plainFlight/plainFlightController/README.md

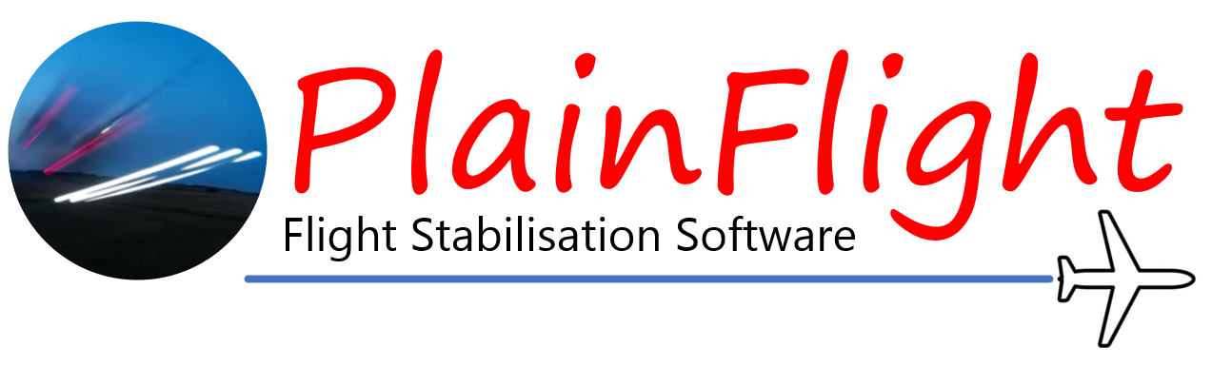
[picture p1: assets/images/PlainFlight Logo Large.PNG]

# Overview
PlainFlight stabilisation software is for the RC pilot who wants to get the most from their model, needs to master an unstable aircraft, or simply counteract environmental conditions for a more enjoyable flight.

Originally created as a home project for fixed wing model aircraft and with the intent of trying to replicate the adaptability and ease of build that the [MultiWii](https://code.google.com/archive/p/multiwii/) project had from many years ago. It quickly met my expectations with its predefined model mixes, quick customisation, good performance, ease of build and low budget parts. These qualities led to friends wanting it on their models and ultimately PlainFlight being refined and posted on GitHub for other hobbyists to have a go and enjoy.

While PlainFlight has been developed for small electric powered model planes it could easily be modified and used upon other small radio-controlled craft. This can be done with little effort as the code is broken down into logical modules and is well commented for those that want to understand or modify for their own purposes.

Several default pre-programmed model mixes can be chosen: Full house plane, full house plane V-tail (Talon), rudder/elevator plane, V-tail plane, or flying wing. The default code settings will compile for a 'full house plane' with control of 4 servo and 2 motor outputs, giving controls of ailerons/flap x2, elevator, rudder and throttle x2 (differential throttle also available for twin motor options). In addition the default code settings include 2 further pass through channels for options such as undercarriage and lights.

The flight controller hardware was originally based on the Seeed Studio XIAO ESP32-S3 but more recently preference has moved to the Waveshare Zero and Tiny due to more available IO's. All of these boards have been chosen for their small size, 32bit processing power and low cost. When combined with the ever-popular MPU6050 IMU a stable 1KHz control loop rate is easily achieved which is more than ample for fixed wing aircraft. 

If you appreciate the time and effort I have invested in this project for the community, then please help me continue development with a kind gesture (Thank you):

Please Donate (https://www.paypal.com/donate/?hosted_button_id=FC4SFQY3846UY)

## Specifications:
As standard PlainFlight has the following specifications:

| Feature | Detail |
| --- | --- |
| Model Mixes | Plane (aileron/flaps/elevator/rudder), Plane (aileron/flaps/V-tail), Plane (rudder/elevator), Plane V-Tail (rudder/elevator), Flying Wing (elevons/rudder), Quadcopter X, quadcopter P, bicopter, chinnook, tricopter, singlecopter, dualcopter. |
| Flight Modes  | Pass through, gyro rate, self levelled, heading hold, acro trainer and self levelled prop-hang.  |
| Actuators | 6 servos and 2 motors. |
| Actuators Refresh | 50Hz, 100Hz, 150Hz, 200Hz, 250Hz, 300Hz, 350Hz, Oneshot125 2KHz, (Or custom with modification).|
| Motors | Direct or differential thrust. |
| Radio Protocols | Sbus, IBus, Spektrum SRXL2 & (CRSF with battery & GPS telemetry on Main). |
| Channel Pass Through | Direct Tx channels to spare PWM outputs (on Main). |
| Battery Monitor | 1-3s Lipo as standard, actively reduces power to motor when voltage drops below a defined threshold.|
| Failsafe | Automatic transition to self levelled mode with user defined failsafe flight trims and cuts throttle.|
| LED | Flight mode indication.|
| Target| Seeed Studio XIAO ESP32-S3. Waveshare ESP32-S3 Tiny or Zero, or any suitable ESP32-S3 board.|
| IMU | MPU6050. |
| Control Loop | Stable 1KHz.|
| WiFi/Web Configurator | Configure gains with your smart device or PC. |
| GPS | CASIC & UBLOX M6/M7/M8/M9/M10 for telemetry purposes only (on Main). |

## Hardware:

All hardware is readily available from hobbyist electronics shops with the main components being:

**Seeed Studio:** [XIAO ESP32-S3](https://wiki.seeedstudio.com/xiao_esp32s3_getting_started/)
**Waveshare:** [Tiny ESP32-S3](https://www.waveshare.com/wiki/ESP32-S3-Tiny)
**Waveshare:** [Zero ESP32-S3](https://www.waveshare.com/wiki/ESP32-S3-Zero)

**MPU6050:** [GY-521 Breakout Board](https://www.amazon.co.uk/MPU-6050-Accelerometer-Gyroscope-Converter-Arduino/dp/B0BZXT477Z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)
**MPU6050:** [ZY-MPU6050 Breakout Board](https://www.aliexpress.com/item/1005005968483503.html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)

The following wiring diagram details how to assemble the flight controller from component parts for a typical model. For full details on wiring and setup please see instructions/directions manual:

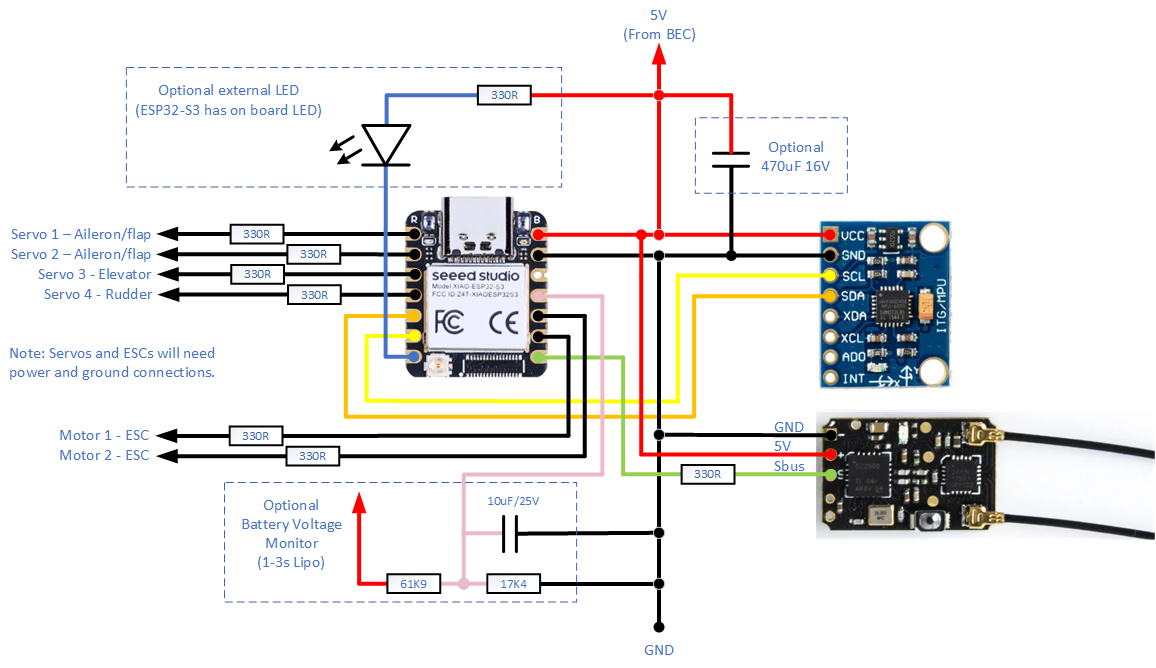
[picture p2: assets/images/plainFlight Controller Connection Diagram.png]
Wiring diagram


A typical 'full house' flight controller build with 6 channels and battery monitoring:
<p align="center">
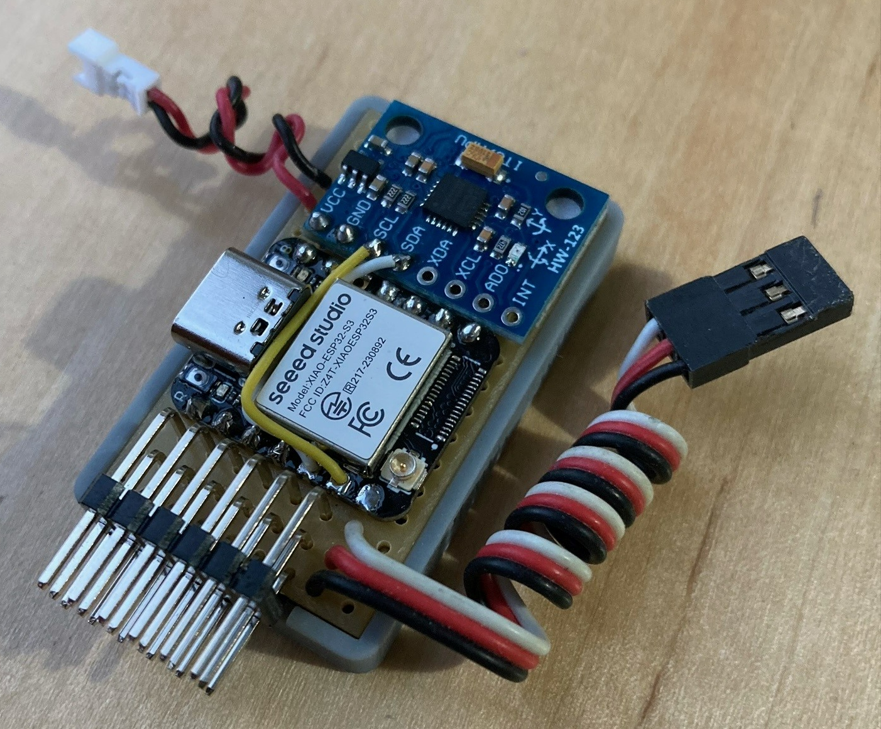
[picture p3: assets/images/PF_5V_Build.PNG]

</p>

## Instruction Manual:

The plainFlightController repository includes a comprehensive instruction manual that takes you through Arduino and flight controller setup for your model:

Instruction Manual

## Web Configurator

Use your smart device to connect wirelessly to your plainFlightController to set gains, rates, servo trims, level trims and battery voltage calibration. This allows easy tuning of your model when out at your flying site.

<p align="center">
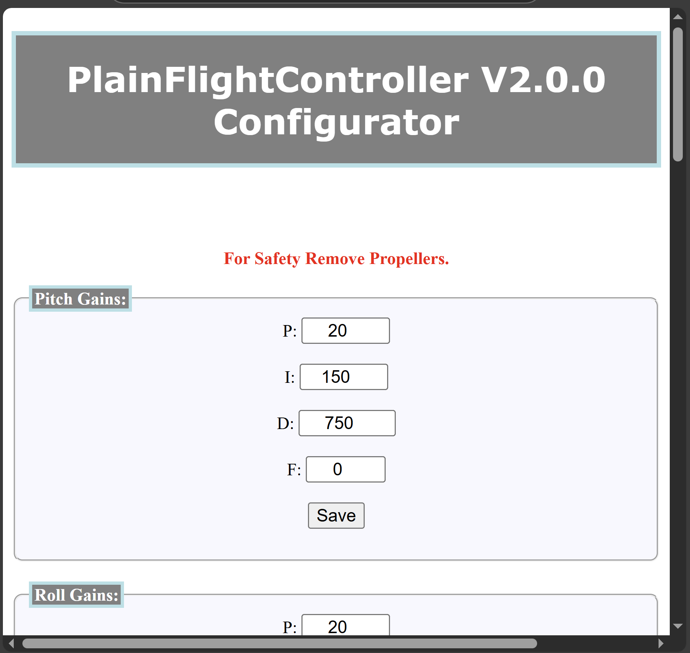
[picture p4: assets/images/WebConfig.png]

</p>

## PCB's:

This project offers PCB's that you can order from pcbway.com or jlcpcb.com. Just copy and paste the zipped files in the manufacture folder onto their websites to get an instant quote. Ordinarily 5-10 bare PCBs with 8-10 day postage comes in under $15US.

 **WSMC**

The Waveshare module carrier (WSMC) is a through hole design that is easy to build. It supports all software features provided by Plain Flight Controller.  

<p align="center">
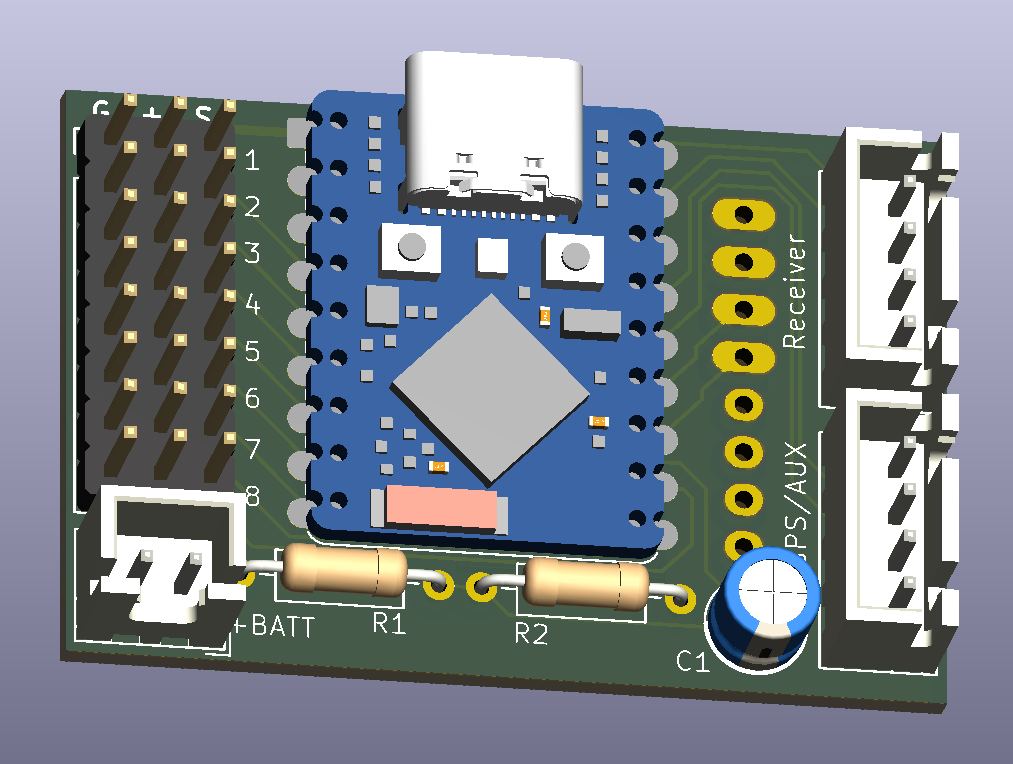
[picture p5: PCBs/WSMC/Assets/WSMC_3D.png]

</p>

 **WSMC Mini**

The Waveshare module carrier Mini (WSMC Mini) is a SMT design. Suitable for smaller models but does require a few discrete 0805 components to be soldered. As per WSMC it supports all software features provided by Plain Flight Controller.

<p align="center">
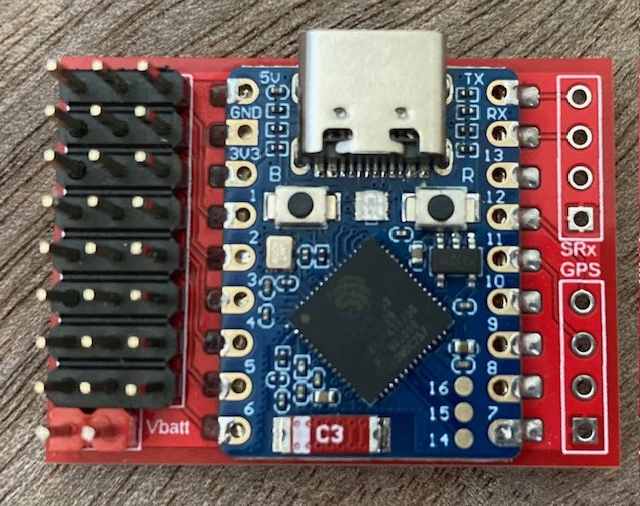
[picture p6: PCBs/WSMC Mini/Assets/WSMC_Mini_Top.png]

</p>

## Movies:

PlainFlight controller introduction, with signature hands off knife edge:

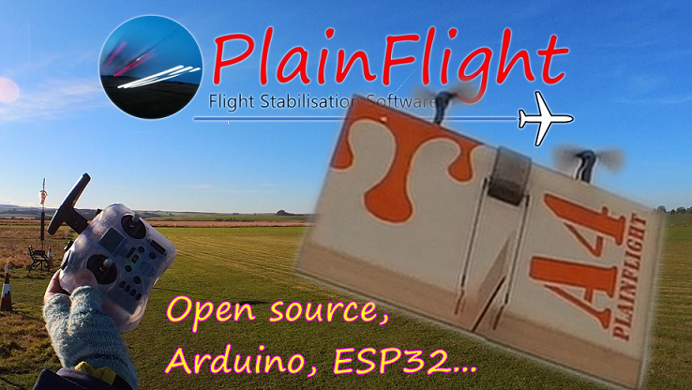
[picture p7: assets/images/vid2.PNG]
Vid1 (https://youtu.be/_j3ObBTJ5ag)


BiCopter is one of many multicopters now available with V2.0.0 release:

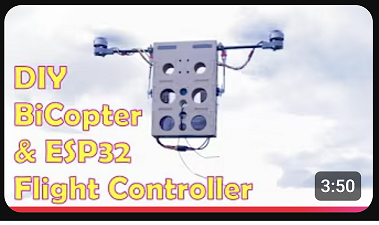
[picture p8: assets/images/BiCopter2.PNG]
Vid4 (https://youtu.be/dmMqcb41KNQ?si=f0tuzXE5j9zyYHdB)


Twin differential flying wing 'A4' - Hands off take off using differential thrust and heading hold feature. As of V2.0.0 this can be achieved with the self level prop-hang feature:

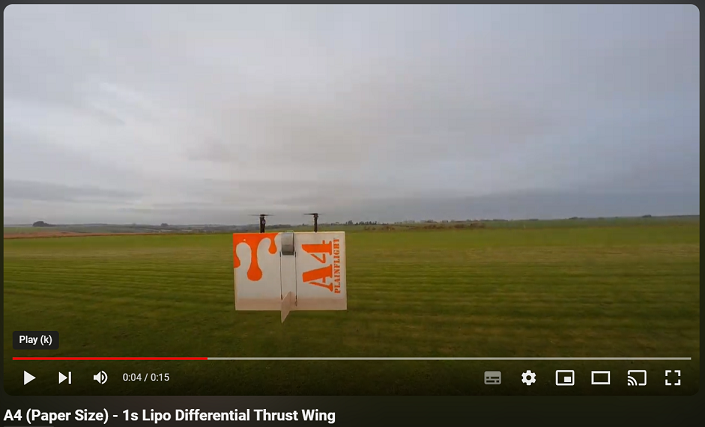
[picture p9: assets/images/A4 Wing.PNG]
Vid2 (https://youtu.be/VJwikkyEEPw)


Testing the effect of D-gain on a fixed wing model. Despite popular belief it works and from my experiences has the benefit of softening P gain 'bobbles' caused by overshoot, and removes the need for throttle attenuation of gains. NOTE: You will need a laptop sized screen for this video:

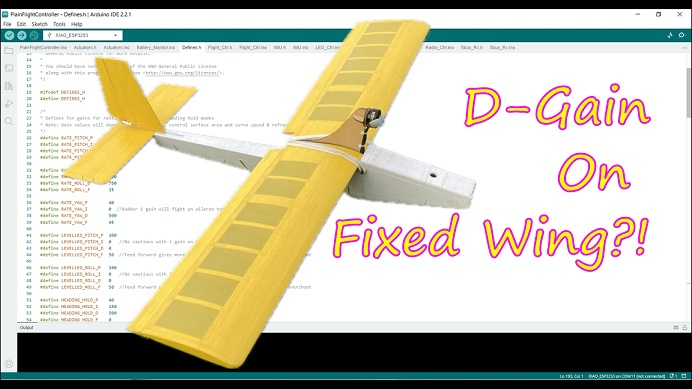
[picture p10: assets/images/D-Gain Thumb.jpg]
Vid3 (https://youtu.be/jslFuttht5o)


## In Development

New features that will be in V3.x.x:

GPS telemetry is in final stages of testing, Casic and Ublox supported.
Battery telemetry.
Rx base class created and Crossfire (CRSF) with telemetry support has been added with full 250Hz update rate.
Move to SoftWire library for I2C as it saves ~250us per loop over Arduino Wire.
Channel pass through so Tx channels can be directly output for undercarriage or lights etc.
Board configurations added ESP32S3 XIAO, Tiny and Zero.
Ability to configure RGB or GRB neopixels.
Enhanced WiFi/web configurator GUI.
Update to configuration.
...These changes are currently on Main for testing.

Plus there is always something new being thought about, and a few secret projects in the works.

## Planned

V3.x.x is planned for release and includes the items mentioned above.

PCB layouts to support Plain Flight Controller.

## Community

I am open to contributions but please be aware it may take me several weeks to assess and test any submissions. Please ensure code is in the same coding style/standard and well commented. I reserve the right to decline contributions that I feel may not be in keeping with the project or standards. 

## Disclaimer:

Do not expect this software to out perform other more established flight controller projects such as ArduPilot, inav, betaFlight etc. This code shall be considered as highly experimental and is not designed or written to any safety critical, or mission critical standards. It is given/shared for free with the knowledge and understanding that this open source flight controller software is only for small hobby based electrically powered model aircraft, or other small hobby radio controlled vehicles. It is intended to be used or modified to suit your needs for small models and is NOT to be used on any manned vehicles. The author(s) shall not be held responsible or accountable for any damage, injury or loss that may be inflicted or incurred as a result of the use or misuse of this code. Use and modify at your own risk and use within accordance of your country's laws and/or regulations. 

By using this, or any part of this software you agree to [this license agreement.](https://github.com/plainFlight/plainFlightController/blob/main/LICENSE)

...and to put it more bluntly:

THIS SOFTWARE IS PROVIDED BY THE CONTRIBUTORS "AS IS" AND ANY EXPRESS OR IMPLIED WARRANTIES, INCLUDING, BUT NOT LIMITED TO, THE IMPLIED WARRANTIES OF MERCHANTABILITY AND FITNESS FOR A PARTICULAR PURPOSE ARE DISCLAIMED. IN NO EVENT SHALL THE CONTRIBUTORS BE LIABLE FOR ANY DIRECT, INDIRECT, INCIDENTAL, SPECIAL, EXEMPLARY, OR CONSEQUENTIAL DAMAGES (INCLUDING, BUT NOT LIMITED TO, PROCUREMENT OF SUBSTITUTE GOODS OR SERVICES; LOSS OF USE, DATA, OR PROFITS; OR BUSINESS INTERRUPTION) HOWEVER CAUSED AND ON ANY THEORY OF LIABILITY, WHETHER IN CONTRACT, STRICT LIABILITY, OR TORT (INCLUDING NEGLIGENCE OR OTHERWISE) ARISING IN ANY WAY OUT OF THE USE OF THIS SOFTWARE, EVEN IF ADVISED OF THE POSSIBILITY OF SUCH DAMAGE.
