plainFlight/plainFlightController/PCBs/WSMC Mini/Schematic/Read Me.txt

Schematic is on its way!

WSMC Mini has the same pin mapping as WSMC. 

Use BoardConfig::WSMC in Config.hpp.
