plainFlight/plainFlightController/PCBs/WSMC Mini/WSMC Mini Specification.txt

Waveshare Module Carrier Mini (WSMC Mini).

Designed by Plain Flight (P.Cook) 2026.

Specification:

Supports: Waveshare ESP32S3 Zero
Supports: 8 PWM Outputs
Supports: serial receivers with telemetry
Supports: GPS
Supports: battery voltage monitoring
Supports: ZY-MPU6050 only
Supports: 5V operation only
Supports: On board Neopixel
Size: 25mm x 34.5mm

Tested By:

Plain Flight
