plainFlight/plainFlightController/assets/images/vid1.PNG

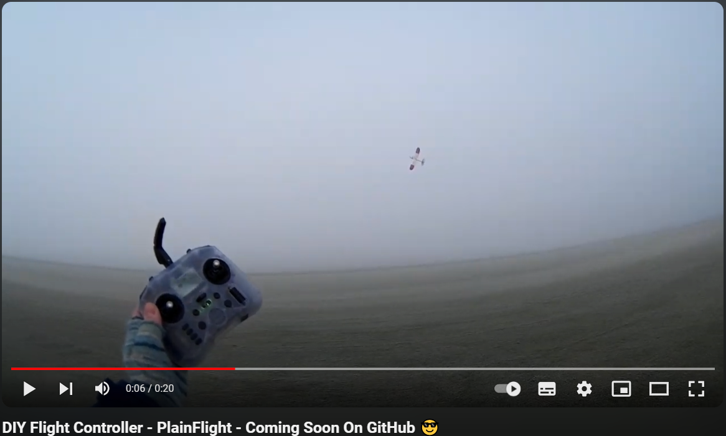
assets/images/vid1.PNG
