plainFlight/plainFlightController/PCBs/WSMC Mini/Assets/WSMC_Mini_Bottom.png

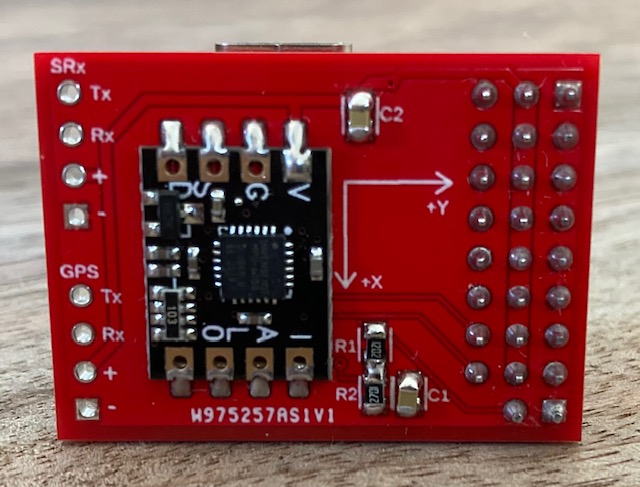
PCBs/WSMC Mini/Assets/WSMC_Mini_Bottom.png
