plainFlight/plainFlightController/PCBs/WSMC/Assets/WSMC_Bottom.png

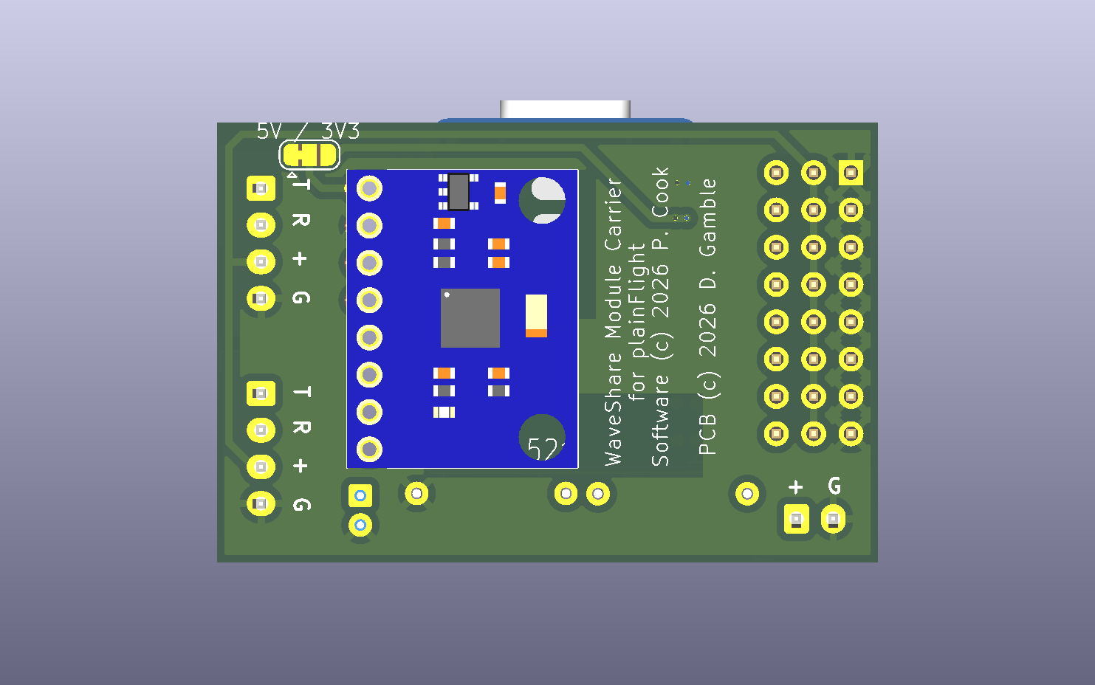
PCBs/WSMC/Assets/WSMC_Bottom.png
