plainFlight/plainFlightController/PCBs/WSMC/Assets/WSMC_Top.png

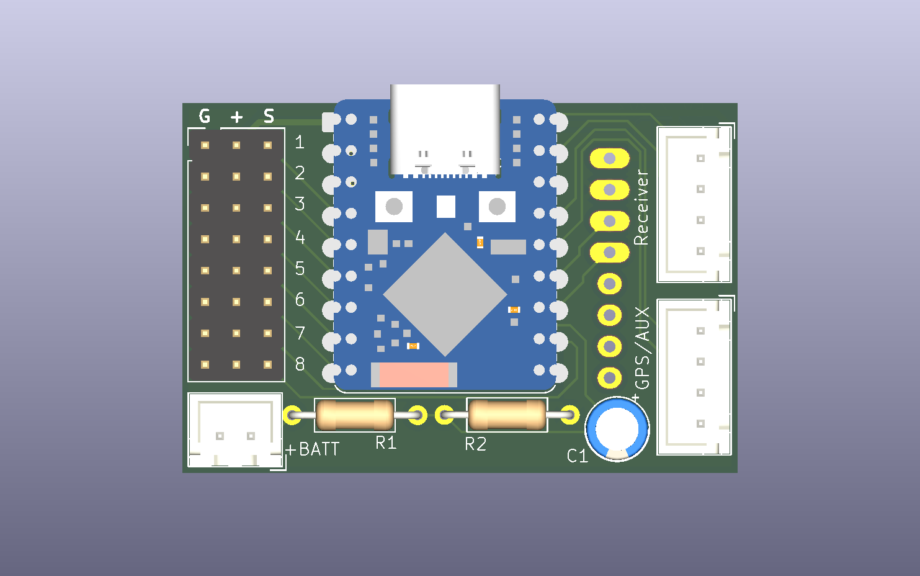
PCBs/WSMC/Assets/WSMC_Top.png
