plainFlight/plainFlightController/(threads)

Thread 2 (2024-05-18):

Compilation error

01Space, 2024-05-18:
Hello! Your code is fantastic! I tried to compile the code and found that the ARDUINO IDE prompted that it could not be compiled.

C:\Users\86186\Downloads\plainFlightController-1.0.0\PlainFlightController\Actuators.ino: In function 'void initActuators()':
Actuators:55:7: error: 'ledcSetup' was not declared in this scope
   55 |       ledcSetup(i, SERVO_REFRESH, LEDC_RESOLUTION);
      |       ^~~~~~~~~
Actuators:56:7: error: 'ledcAttachPin' was not declared in this scope; did you mean 'ledcAttach'?
   56 |       ledcAttachPin(pwmPin[i], i);
      |       ^~~~~~~~~~~~~
      |       ledcAttach
Actuators:74:9: error: 'ledcSetup' was not declared in this scope
   74 |         ledcSetup(i, SERVO_REFRESH, LEDC_RESOLUTION);
      |         ^~~~~~~~~
Actuators:75:9: error: 'ledcAttachPin' was not declared in this scope; did you mean 'ledcAttach'?
   75 |         ledcAttachPin(pwmPin[i], i);
      |         ^~~~~~~~~~~~~
      |         ledcAttach

plainFlight, 2024-05-18:
Sounds like you have not downloaded/installed the ESP32 Espressif library... see the instructions for what libraries are needed. The functions Arduino is complaining about are part of that library.

01Space, 2024-05-19:
Thank you! I have resolved the compilation issue. The problem is that I am using Espressif Systems ESP32 (3.0.0-RC3) and can compile using an older version (2.0.14)
Can you share the 3D printing design files and ARDUINO source code of BiCopter/DualCopter? Many people are very interested in your BiCopter/DualCopter project! Do you use Discord server? You can establish a Discord server for PlainFlightController, so that anyone interested in PlainFlightController can join the Discord server for communication or discussion.

Closed 2024-05-19.

Thread 4 (2024-09-21):

Not compiling with newest Arduino IDE

Eisbaeeer, 2024-09-21:
Hi
I tried to compile fresh installation of Arduino (as in manual).

Arduino 2.3.2
MPU6050 1.3.1
esp32 Espressif Systems 3.0.4

Throwing this error:
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

Is it possible to move the source to platformio?
This will be more stable regarding updates of lib´s.

Greets Lars

plainFlight, 2024-09-21:
Manual shows 2.0.14 for Espressif Systems library. It will compile with that version.

Eisbaeeer, 2024-09-22:
The sketch is compiling with 2.0.14
Thanks a lot!

Closed 2024-09-22.

Thread 5 (2024-10-29):

Board compatibility issue

Eisbaeeer, 2024-10-29:
Im using a Waveshare ESP32-S3 ZERO board.
I love this project. You spend so much time for it.
I converted to platformio for using other boards. Are you interested for a pull request?
Greets Lars

Closed 2024-10-30.

Thread 6 (2024-11-29):

ESP32-WROOM-32

alex2root, 2024-11-29:
Hello,

I really like your project!)))

I am using the ESP32-WROOM-32,

and I hope that in the updated project, I will still be able to use my affordable alternative.

kd8ua, 2024-12-06:
Hello Alex,

This is one of several projects that I am following and hoping to replicate and perhaps even improve on.

Though, my expertise is minimal I have been having some success.  I have assembled a board for the plainFlightController using the schematic, photos and compiled and uploaded the code available from this project successfully.

The good news is that I did not produce any magic smoke when I  powered up the board. I hooked up a couple of servos to the board this evening and after power up, when I lift and move the board, the servos react as if they are trying to maintain level flight.  So that looks good too.

I am looking at plans and even kits for a suitable airplane platform, as well as gathering all of the other necessary parts. to put an airplane in the air early next spring.                                                              

What stage are you in this project Alex?
Hope to hear from you and perhaps compare notes as we work on this project?

Regards, Don

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

Thread 8 (2025-04-01):

Defines.h vs. defines.h

ofpkubi, 2025-04-01:
Hi,

I'm trying to compile v1.1.1 the project on Linux and it complains about "defines.h" in Sbus_Rx.ino.
There is a "Defines.h" (capital D), so if I fix the name in Sbus_Rx.ino, it complies.

I think, it is a typo that causes issue only with case sensitive filesystems (e.g., ext4 in Linux).

plainFlight, 2025-05-04:
Closed as V2.0.0 no longer uses Defines.h.

Closed 2025-05-04.

Thread 9 (2025-04-27):

im using MP6500 instead of MPU6050 GY-521

ranger2012, 2025-04-27:
is there a way to change the IMU library frin MPU6050 to MPU6500..?

plainFlight, 2025-05-04:
Closed as not an issue with the code base.

Closed 2025-05-04.
