plainFlight/plainFlightController/PCBs/WSMC/Schematic/WSMC_Schematic V1.0.pdf

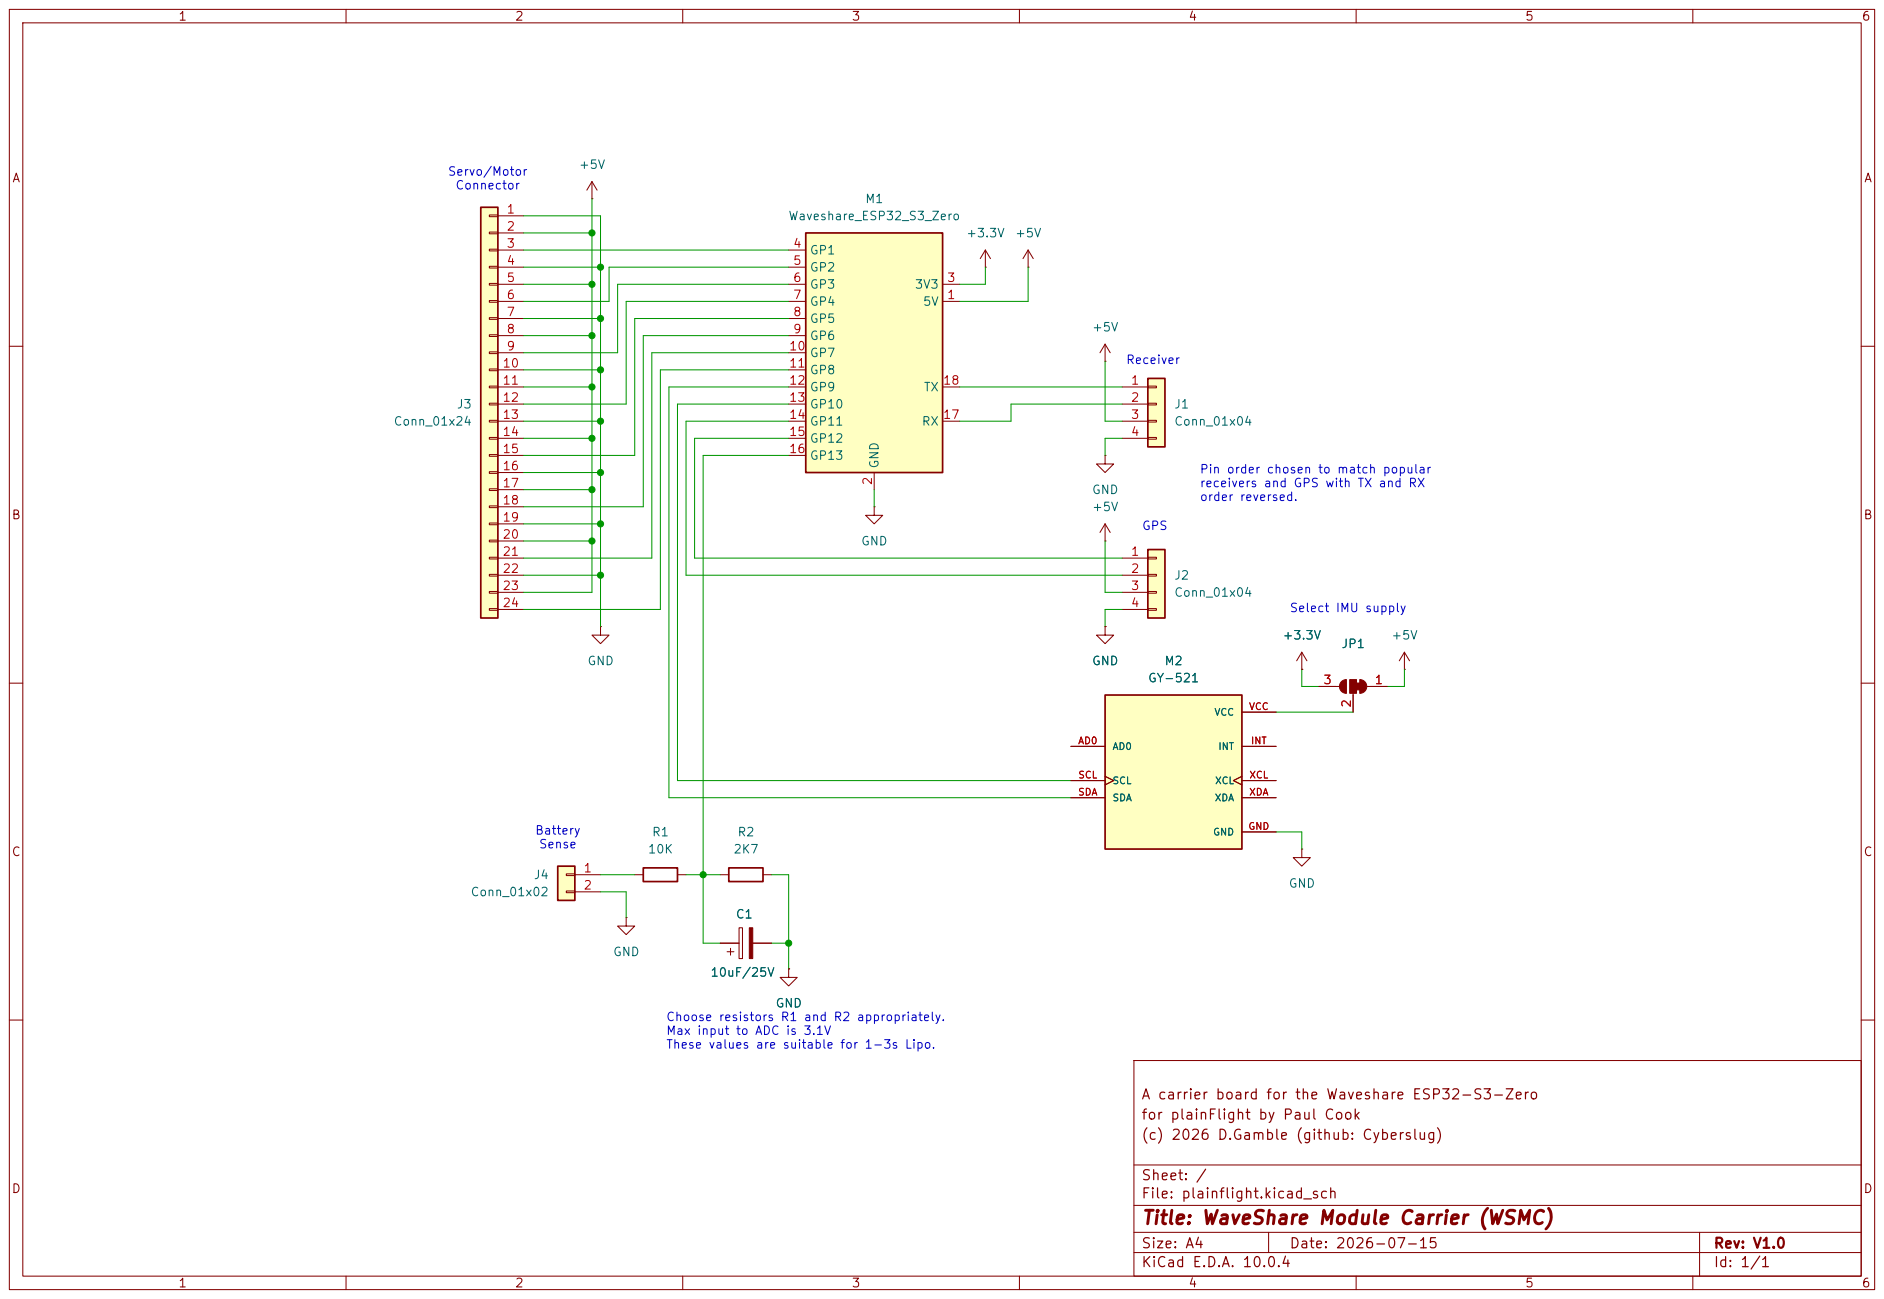
[picture p77: page 1]

receivers and GPS with TX and RX order reversed. Battery Sense

A carrier board for the Waveshare ESP32-S3-Zero
for plainFlight by Paul Cook
(c) 2026 D.Gamble (github: Cyberslug)

Sheet: /
File: plainflight.kicad_sch
Title: WaveShare Module Carrier (WSMC)

Size: A4 | Rev: V1.0
KiCad E.D.A. 10.0.4 | Id: 1/1
