plainFlight/plainFlightController/PlainFlightController/PlainFlightController.ino

/* 
* Copyright (c) 2025 P.Cook (alias 'plainFlight')
*
* This file is part of the PlainFlightController distribution (https://github.com/plainFlight/plainFlightController).
* 
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
* You should have received a copy of the GNU General Public License 
* along with this program. If not, see <http://www.gnu.org/licenses/>.
*/

/**
* @file   plainFlightController.ino 
* @brief  Contains Arduino setup and loop.
*/

#include "FlightControl.hpp"


//Create instance of FlightControl...
FlightControl plainFlightController = FlightControl();


void setup() 
{
  plainFlightController.begin(); 
}


void loop() 
{
 plainFlightController.operate();
}
