plainFlight/plainFlightController/PlainFlightController/WifiConfig.cpp

/* 
* Copyright (c) 2025 P.Cook (alias 'plainFlight')
*
* This file is part of the PlainFlightController distribution (https://github.com/plainFlight/plainFlightController).
* 
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
* You should have received a copy of the GNU General Public License 
* along with this program. If not, see <http://www.gnu.org/licenses/>.
*/

/**
* @file   WifiConfig.cpp
* @brief  This class contains methods that controls the wifi and HTML web page.
*/

#include "WifiConfig.hpp"
#include "Config.hpp"
#include "InternalConfig.hpp"


/**
* @brief    Constructore.
* @param    Parameters to be displayed/updated by the WiFi configurator
* @note     TODO - this can be done better in the hpp.
*/
WifiConfig::WifiConfig(FileSystem::NonVolatileData * const theData, float* const batteryVoltage, float* const pitch, float* const roll, float* const yaw)
{
  m_webData = theData;
  m_batteryVoltage = batteryVoltage;
  m_pitch = pitch;
  m_roll = roll;
  m_yaw = yaw;
}


/**
* @brief  Wifi state machine enabled by high throttle stick position when disarmed.
*/
void 
WifiConfig::doWiFiStateMachine()
{
  switch (m_state)
  {
    case WifiState::OFF:
      if constexpr(InternalConfig::DEBUG_CONFIGURATOR){Serial.println("wifi_off");}
      break;

    case WifiState::START:
    {
      if constexpr(InternalConfig::DEBUG_CONFIGURATOR){Serial.println("start_wifi");}
      const bool ok = startWifiConfigurator();
      m_state = (ok) ? WifiState::SERV_CLIENT : WifiState::OFF;
      break;
    }

    default:
    case WifiState::STOP:
      if constexpr(InternalConfig::DEBUG_CONFIGURATOR){Serial.println("stop_wifi");}
      stopWifiConfigurator();
      m_state = WifiState::OFF;
      break;
    
    case WifiState::SERV_CLIENT:
    {
      //serviceWifiConfigurator();
      dnsServer.processNextRequest();
      server.handleClient();
      break;  
    } 
  }
}


/**
* @brief  Initiates a wifi access point and server.
* @return True if wifi started.
*/
bool 
WifiConfig::startWifiConfigurator() 
{
  if constexpr(InternalConfig::DEBUG_CONFIGURATOR){Serial.println("Configuring access point...");}

  IPAddress m_localIP(192,168,4,1);
  IPAddress m_gateway(192,168,4,1);
  IPAddress m_subnet(255,255,255,0);

  WiFi.softAPConfig(m_localIP, m_gateway, m_subnet);

  if (!WiFi.softAP(SSID, PASSWORD))
  {
    if constexpr(InternalConfig::DEBUG_CONFIGURATOR){Serial.println("Soft AP failed.");}
    return false;
  }

  m_localIP = WiFi.softAPIP();
  //Using dns to create a captive portal in an effort to automatically open a webpage.
  dnsServer.start(53, "*", m_localIP);

  //Pages
  server.on(STR_PAGE_ROOT, HTTP_GET, [this](){handleRoot();});
  server.on(STR_PAGE_MAIN, HTTP_GET, [this](){sendMain();});
  
  //Forms
  server.on(STR_FORM_PITCH, HTTP_POST, [this](){handlePitchGains();});
  server.on(STR_FORM_ROLL, HTTP_POST, [this](){handleRollGains();});
  server.on(STR_FORM_YAW, HTTP_POST, [this](){handleYawGains();});
  server.on(STR_FORM_RATES, HTTP_POST, [this](){handleDegreeRates();});
  server.on(STR_FORM_ANGLE, HTTP_POST, [this](){handleMaxLevelAngles();});
  server.on(STR_FORM_LEVEL_TRIMS, HTTP_POST, [this](){handleLevelTrims();});
  server.on(STR_FORM_SERVO_TRIMS, HTTP_POST, [this](){handleServoTrims();});
  server.on(STR_FORM_VOLT_TRIM, HTTP_POST, [this](){handleBatteryTrim();});

  //Captive portal detection
  server.on(STR_PORTAL_ROOT_1, HTTP_GET, [this](){handleRoot();});
  server.on(STR_PORTAL_ROOT_2, HTTP_GET, [this](){handleRoot();});
  server.on(STR_PORTAL_ROOT_3, HTTP_GET, [this](){handleRoot();});
  server.on(STR_PORTAL_ROOT_4, HTTP_GET, [this](){handleRoot();});
  server.on(STR_PORTAL_ROOT_5, HTTP_GET, [this](){handleRoot();});
  server.onNotFound([this](){handleNotFound();});

  //Handle live updates
  server.on(STR_LIVE_UPDATE_MODEL, HTTP_GET, [this](){handleModelUpdates();});

  server.begin();
  return true;
}


/**
* @brief  Disconnects and turns off wifi.
* @note   Wifi is always off when the model is armed.
*/
void 
WifiConfig::stopWifiConfigurator() 
{
  if constexpr(InternalConfig::DEBUG_CONFIGURATOR){Serial.println("Client Disconnected.");}
  WiFi.softAPdisconnect();
  WiFi.mode(WIFI_OFF);
  if constexpr(InternalConfig::DEBUG_CONFIGURATOR){Serial.println("Wifi stopped");}
}


/**
* @brief  Informs caller when new data has been captured.
* @return true when a value has been updated.
*/
bool 
WifiConfig::hasUpdatedData()
{
  const bool updated = m_dataUpdated;
  m_dataUpdated = false;
  return updated;
}


/**
* @brief    Send the main HTML page.
*/
void
WifiConfig::sendMain()
{
  int32_t degreesPerSec = 0;

  if constexpr(Config::GYRO_RATE == GyroRate::IS_250_DEGS_SECOND)
  {
    degreesPerSec = 250;
  }
  else
  {
    if constexpr(Config::GYRO_RATE == GyroRate::IS_500_DEGS_SECOND)
    {
      degreesPerSec = 500;
    }
  }

  const int32_t n = snprintf (m_html, HTML_DOC_BUFF_SIZE, INDEX_HTML, 
                          InternalConfig::SOFTWARE_VERSION,
                          m_webData->gains.pitch.p, m_webData->gains.pitch.i, (m_webData->gains.pitch.d/SCALE_D_GAIN), m_webData->gains.pitch.ff, m_webData->gains.pitch.dff,
                          m_webData->gains.roll.p, m_webData->gains.roll.i, (m_webData->gains.roll.d/SCALE_D_GAIN), m_webData->gains.roll.ff, m_webData->gains.roll.dff, 
                          m_webData->gains.yaw.p, m_webData->gains.yaw.i, (m_webData->gains.yaw.d/SCALE_D_GAIN), m_webData->gains.yaw.ff, m_webData->gains.yaw.dff, 
                          (m_webData->rates.pitch/SCALE_RATES), degreesPerSec, (m_webData->rates.roll/SCALE_RATES), degreesPerSec, (m_webData->rates.yaw/SCALE_RATES), degreesPerSec, 
                          (m_webData->maxAngle.pitch/SCALE_MAX_ANGLE), (m_webData->maxAngle.roll/SCALE_MAX_ANGLE), 
                          *m_pitch, *m_roll, *m_yaw, m_webData->levelTrim.pitch, m_webData->levelTrim.roll, m_webData->levelTrim.yaw,
                          m_webData->servoTrim.servo1, m_webData->servoTrim.servo2, m_webData->servoTrim.servo3, m_webData->servoTrim.servo4,
                          *m_batteryVoltage, m_webData->batteryScaler);

  if (HTML_DOC_BUFF_SIZE < (n+1))
  {
    Serial.println("snprintf buff size error !");
  }
  else
  {
    server.send(200, STR_TEXT_HTML, m_html);
  }
}
    

/**
* @brief    Handle root.
*/
void
WifiConfig::handleRoot()
{
  if constexpr(InternalConfig::DEBUG_CONFIGURATOR){Serial.println("handle root");}

  server.sendHeader(STR_LOCATION, STR_ESP_MAIN_URL, true);
  server.send(302, STR_TEXT_PLAIN, "");
}


/**
* @brief    Handle web requests that are not known.
*/
void
WifiConfig::handleNotFound()
{
  if constexpr(InternalConfig::DEBUG_CONFIGURATOR){Serial.println("handle not found");}

  server.sendHeader(STR_LOCATION, STR_ESP_MAIN_URL, true);
  server.send(302, STR_TEXT_PLAIN, "");
}


/**
* @brief    Common decoding method for all PIDF gains.
* @param    Pointer to gains structure to populate.
*/
void
WifiConfig::updateGains(PIDF::Gains* const theGains)
{
  const int32_t P = server.arg(ARG_P).toInt();
  const int32_t I = server.arg(ARG_I).toInt();
  const int32_t D = server.arg(ARG_D).toInt() * SCALE_D_GAIN;
  const int32_t F = server.arg(ARG_F).toInt();
  const int32_t DFF = server.arg(ARG_DFF).toInt();

  if constexpr(InternalConfig::DEBUG_CONFIGURATOR)
  {
    Serial.println("Gains updated:");
    Serial.println("P:" + String(P));
    Serial.println("I:" + String(I));
    Serial.println("D:" + String(D));
    Serial.println("F:" + String(F));
    Serial.println("DFF:" + String(DFF));
  }

  theGains->p = P;
  theGains->i = I;
  theGains->d = D;
  theGains->ff = F;
  theGains->dff = DFF;
}


/**
* @brief    Decode the pitch gains.
*/
void
WifiConfig::handlePitchGains()
{
  updateGains(&m_webData->gains.pitch);
  server.sendHeader(STR_LOCATION, STR_PAGE_MAIN);
  server.send(303);
  m_dataUpdated = true;
}


/**
* @brief    Decode the roll gains.
*/
void
WifiConfig::handleRollGains()
{
  updateGains(&m_webData->gains.roll);
  server.sendHeader(STR_LOCATION, STR_PAGE_MAIN);
  server.send(303);
  m_dataUpdated = true;
}


/**
* @brief    Decode the yaw gains.
*/
void
WifiConfig::handleYawGains()
{
  updateGains(&m_webData->gains.yaw);
  server.sendHeader(STR_LOCATION, STR_PAGE_MAIN);
  server.send(303);
  m_dataUpdated = true;
}


/**
* @brief    Decode the degrees pers second rates
*/
void
WifiConfig::handleDegreeRates()
{
  const int32_t pitch = server.arg(ARG_PITCH).toInt() * SCALE_RATES;
  const int32_t roll = server.arg(ARG_ROLL).toInt() * SCALE_RATES;
  const int32_t yaw = server.arg(ARG_YAW).toInt() * SCALE_RATES;

  if constexpr(InternalConfig::DEBUG_CONFIGURATOR)
  {
    Serial.println("Degree rates updated:");
    Serial.println("Pitch:" + String(pitch));
    Serial.println("Roll:" + String(roll));
    Serial.println("Yaw:" + String(yaw));
  }

  m_webData->rates.pitch = pitch;
  m_webData->rates.roll = roll;
  m_webData->rates.yaw = yaw;

  server.sendHeader(STR_LOCATION, STR_PAGE_MAIN);
  server.send(303);
  m_dataUpdated = true;
}


/**
* @brief    Decode the max angle trims
*/
void
WifiConfig::handleMaxLevelAngles()
{
  const int32_t pitch = server.arg(ARG_PITCH).toInt() * SCALE_MAX_ANGLE;
  const int32_t roll = server.arg(ARG_ROLL).toInt() * SCALE_MAX_ANGLE;

  if constexpr(InternalConfig::DEBUG_CONFIGURATOR)
  {
    Serial.println("Level rates updated:");
    Serial.println("Pitch:" + String(pitch));
    Serial.println("Roll:" + String(roll));
  }

  m_webData->maxAngle.pitch = pitch;
  m_webData->maxAngle.roll = roll;

  server.sendHeader(STR_LOCATION, STR_PAGE_MAIN);
  server.send(303);
  m_dataUpdated = true;
}


/**
* @brief    Decode the new level trims
*/
void
WifiConfig::handleLevelTrims()
{
  const float pitch = server.arg(ARG_PITCH).toFloat();
  const float roll = server.arg(ARG_ROLL).toFloat();
  const float yaw = server.arg(ARG_YAW).toFloat();

  if constexpr(InternalConfig::DEBUG_CONFIGURATOR)
  {
    Serial.println("Level trims updated:");
    Serial.println("Pitch:" + String(pitch));
    Serial.println("Roll:" + String(roll));
    Serial.println("Yaw:" + String(yaw));
  }

  m_webData->levelTrim.pitch = pitch;
  m_webData->levelTrim.roll = roll;
  m_webData->levelTrim.yaw = yaw;     //Note: This is used to trim level when in prophang mode

  server.sendHeader(STR_LOCATION, STR_PAGE_MAIN);
  server.send(303);
  m_dataUpdated = true;
}


/**
* @brief    Decode the new servo trims
*/
void
WifiConfig::handleServoTrims()
{
  const int32_t servo1 = server.arg(ARG_SERVO1).toInt();
  const int32_t servo2 = server.arg(ARG_SERVO2).toInt();
  const int32_t servo3 = server.arg(ARG_SERVO3).toInt();
  const int32_t servo4 = server.arg(ARG_SERVO4).toInt();

  if constexpr(InternalConfig::DEBUG_CONFIGURATOR)
  {
    Serial.println("Servo trims updated:");
    Serial.println("servo1:" + String(servo1));
    Serial.println("servo2:" + String(servo2));
    Serial.println("servo3:" + String(servo3));
    Serial.println("servo4:" + String(servo4));
  }

  m_webData->servoTrim.servo1 = servo1;
  m_webData->servoTrim.servo2 = servo2;
  m_webData->servoTrim.servo3 = servo3;
  m_webData->servoTrim.servo4 = servo4;

  server.sendHeader(STR_LOCATION, STR_PAGE_MAIN);
  server.send(303);
  m_dataUpdated = true;
}


/**
* @brief    Decode the new battery scaler
*/
void
WifiConfig::handleBatteryTrim()
{
  const float voltCalibration = server.arg(ARG_VOLTS).toFloat();

  if constexpr(InternalConfig::DEBUG_CONFIGURATOR)
  {
    Serial.println("Voltage calibration updated:");
    Serial.print("Cal:");
    Serial.println(voltCalibration, 5);
  }

  m_webData->batteryScaler = voltCalibration;

  server.sendHeader(STR_LOCATION, STR_PAGE_MAIN);
  server.send(303);
  m_dataUpdated = true;
}


/**
* @brief    Process and send live updates.
*/
void
WifiConfig::handleModelUpdates()
{
  constexpr uint8_t BUFF_SIZE = 96U;
  char json[BUFF_SIZE] = {0};

  const int32_t n = snprintf(
            json, sizeof(json),
            "{\"pitch\":%.1f,\"roll\":%.1f,\"yaw\":%.1f,\"volts\":%.2f}",
            *m_pitch, *m_roll, *m_yaw, *m_batteryVoltage);

  if constexpr(InternalConfig::DEBUG_CONFIGURATOR)
  {
    Serial.println("Get angle/volts Updates:");
    Serial.println(json);
  }

  if (BUFF_SIZE < (n+1))
  {
    Serial.println("snprintf buff size error !");
  }
  else
  {
    server.send(200, STR_APP_JSON, json);
  }
}
