plainFlight/plainFlightController/PlainFlightController/Mpu6050.cpp

/* 
* Copyright (c) 2025 P.Cook (alias 'plainFlight')
*
* This file is part of the PlainFlightController distribution (https://github.com/plainFlight/plainFlightController).
* 
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
* You should have received a copy of the GNU General Public License 
* along with this program. If not, see <http://www.gnu.org/licenses/>.
*/

/**
* @file   Mpu6050.hpp
* @brief  This class contains methods that handle communications with the MPU6050.
*/

#include "Mpu6050.hpp"
#include "InternalConfig.hpp"
#include "CommonTypes.hpp"

/**
* @brief    Constructor that sets the desired gyro rate.
*/
Mpu6050::Mpu6050()
{
  if constexpr(Config::GYRO_RATE == GyroRate::IS_250_DEGS_SECOND)
  {
    m_scaleFactor = GYRO_SCALE_FACTOR_250;
  }

  if constexpr(Config::GYRO_RATE == GyroRate::IS_500_DEGS_SECOND)
  {
    m_scaleFactor = GYRO_SCALE_FACTOR_500;
  }
}


/**
* @brief    Initialises the MPU6050.
*/
void
Mpu6050::initialise()
{
  begin();
  reset();
  delay(50);

  setConfig(CONFIG);

  if constexpr(Config::GYRO_RATE == GyroRate::IS_250_DEGS_SECOND)
  {
    setGyroConfig(GYRO_CONFIG_250);
  }

  if constexpr(Config::GYRO_RATE == GyroRate::IS_500_DEGS_SECOND)
  {
    setGyroConfig(GYRO_CONFIG_500);
  }

  setAccelerometerConfig(ACCEL_CONFIG);  
}


/**
* @brief    Sets up and start the SoftWire I2C transfer.
*/
void 
Mpu6050::begin()
{
  i2c.begin(Config::ESP32S3.I2C_SDA,Config::ESP32S3.I2C_SCL,I2C_CLK_1MHZ);
  i2c.begin();
}


/**
* @brief    Resets the MPU6050.
* @note     Reset initialises all registers to zero.
*/
void 
Mpu6050::reset()
{
  i2c.beginTransmission(MPU6050_ADD);
  i2c.write(0x6B);         //Register
  i2c.write(0x00);         //Data
  i2c.endTransmission(true);
}


/**
* @brief    Sets the mpu configuration.
* @param    Data representing the desired configuration register value.
*/
void 
Mpu6050::setConfig(const uint8_t config)
{
  i2c.beginTransmission(MPU6050_ADD);
  i2c.write(0x1A);         //Register
  i2c.write(config);       //Data
  i2c.endTransmission(true);
}


/**
* @brief    Sets the gyro scale to operate at.
* @param    Data representing the desired configuration register value.
*/
void 
Mpu6050::setGyroConfig(const uint8_t gyroScale)
{
  i2c.beginTransmission(MPU6050_ADD);
  i2c.write(0x1B);         //Register
  i2c.write(gyroScale);    //Data
  i2c.endTransmission(true);
}


/**
* @brief    Sets the accelerometer scale to operate at.
* @param    Data representing the desired configuration register value.
*/
void 
Mpu6050::setAccelerometerConfig(const uint8_t accelScale)
{
  i2c.beginTransmission(MPU6050_ADD);
  i2c.write(0x1C);         //Register
  i2c.write(accelScale);   //Data
  i2c.endTransmission(true);
}


/**
* @brief    Reads the gyro, temperature and accelerometer data form the mpu6050.
* @param    Pointer to data structure where mpu data is stored.
* @return   true when data successfully read.
*/
bool
Mpu6050::readData(MpuData* const data)
{
  i2c.beginTransmission(MPU6050_ADD);
  i2c.write(0x3B);                     //Register
  i2c.endTransmission(false);
  const uint8_t bytesReceived = i2c.requestFrom(MPU6050_ADD, 14, true);  //Get gyro, temp and accelerometer data

  if (14U == bytesReceived)
  {
    const int16_t rawA_X = (static_cast<int16_t>(i2c.read()) << 8) | static_cast<int16_t>(i2c.read());
    const int16_t rawA_Y = (static_cast<int16_t>(i2c.read()) << 8) | static_cast<int16_t>(i2c.read());
    const int16_t rawA_Z = (static_cast<int16_t>(i2c.read()) << 8) | static_cast<int16_t>(i2c.read());
    
    data->temperature    = (static_cast<int16_t>(i2c.read()) << 8) | static_cast<int16_t>(i2c.read());
    
    const int16_t rawG_X = (static_cast<int16_t>(i2c.read()) << 8) | static_cast<int16_t>(i2c.read());
    const int16_t rawG_Y = (static_cast<int16_t>(i2c.read()) << 8) | static_cast<int16_t>(i2c.read());
    const int16_t rawG_Z = (static_cast<int16_t>(i2c.read()) << 8) | static_cast<int16_t>(i2c.read());

    // Remap axes using compile-time matrix evaluation
    data->rawAccel_X = remapAxis<0>(rawA_X, rawA_Y, rawA_Z);
    data->rawAccel_Y = remapAxis<1>(rawA_X, rawA_Y, rawA_Z);
    data->rawAccel_Z = remapAxis<2>(rawA_X, rawA_Y, rawA_Z);

    data->rawGyro_X  = remapAxis<0>(rawG_X, rawG_Y, rawG_Z);
    data->rawGyro_Y  = remapAxis<1>(rawG_X, rawG_Y, rawG_Z);
    data->rawGyro_Z  = remapAxis<2>(rawG_X, rawG_Y, rawG_Z);

    // Scaling math
    data->gyro_X = static_cast<float>(data->rawGyro_X - data->gyroOffset_X) / m_scaleFactor;
    data->accel_X = static_cast<float>(data->rawAccel_X) / ACCEL_SCALE_FACTOR_16G;
    data->gyro_Y = static_cast<float>(data->rawGyro_Y - data->gyroOffset_Y) / m_scaleFactor;
    data->accel_Y = static_cast<float>(data->rawAccel_Y) / ACCEL_SCALE_FACTOR_16G;
    data->gyro_Z = static_cast<float>(data->rawGyro_Z - data->gyroOffset_Z) / m_scaleFactor;
    data->accel_Z = static_cast<float>(data->rawAccel_Z) / ACCEL_SCALE_FACTOR_16G;
 
    return true;
  }
  else
  {
    return false;
  }
}


/**
* @brief    Reads a register data value.
* @param    Data representing the desired register address to read.
*/
uint8_t
Mpu6050::readRegister(const uint8_t theRegister)
{
  i2c.beginTransmission(MPU6050_ADD);
  i2c.write(theRegister);   //Register
  i2c.endTransmission(false);
  i2c.requestFrom(MPU6050_ADD, 1, true);  //Get gyro, temp and accelerometer data
  return i2c.read();
}


/**
* @brief    Gets the mpu device ID.
* @return   The device ID.
*/
uint8_t
Mpu6050::whoAmI()
{
  i2c.beginTransmission(MPU6050_ADD);
  i2c.write(0x75);         //Register
  i2c.endTransmission(false);
  i2c.requestFrom(MPU6050_ADD, 1, true);  //Get who am I data
  return i2c.read();
}
