plainFlight/plainFlightController/PlainFlightController/BoardConfig.hpp

/* 
* Copyright (c) 2025 P.Cook (alias 'plainFlight')
*
* This file is part of the PlainFlightController distribution (https://github.com/plainFlight/plainFlightController).
* 
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
* You should have received a copy of the GNU General Public License 
* along with this program. If not, see <http://www.gnu.org/licenses/>.
*/

/**
* @file   BoardConfig.hpp
* @brief  This module contains structures that define different ESP32S3 boards.
*/
#pragma once


namespace BoardConfig
{

/**
* @brief  Structure representing all IO used by Plain Flight Controller.
* @note   Some boards may have additional spare IO.
*/
struct Board
{
  //LEDC channel pins used for servos/motors.
  const uint8_t OUTPUT_1;
  const uint8_t OUTPUT_2;
  const uint8_t OUTPUT_3;
  const uint8_t OUTPUT_4;
  const uint8_t OUTPUT_5;
  const uint8_t OUTPUT_6;
  const uint8_t OUTPUT_7;
  const uint8_t OUTPUT_8;
  //Other IO pins
  const uint8_t LED_ON_BOARD;
  const uint8_t I2C_SDA;
  const uint8_t I2C_SCL;
  const uint8_t SERIAL_PORT_1_RX;
  const uint8_t SERIAL_PORT_1_TX;
  const uint8_t SERIAL_PORT_2_RX;
  const uint8_t SERIAL_PORT_2_TX;
  const uint8_t LED_EXTERNAL;
  const uint8_t BATTERY_ADC;
  //Options
  const bool SINK_ONBOARD_LED;          //Set true to sink onboard LED, false to source onboard LED. 
  const bool HAS_NEOPIXEL;              //When using a board with a Neopixel i.e. WS2812 or equivalent.
  const bool SWAP_NEOPIXEL_RGB_TO_GRB;  //If your neopixel ordering is green-red-blue then set this to true.
};


  /**
  * @brief Structure representing the standard IO map for ESP32S3-XIAO by Seed Studio.
  * @note Insufficient pins for GPS.
  */
  static constexpr Board XIAO = 
  {
    //LEDC channel pins used for servos/motors.
    .OUTPUT_1           = 1U, //GPIO1 = D0
    .OUTPUT_2           = 2U, //GPIO2 = D1
    .OUTPUT_3           = 3U, //GPIO3 = D2
    .OUTPUT_4           = 4U, //GPIO4 = D3
    .OUTPUT_5           = 7U, //GPIO7 = D8
    .OUTPUT_6           = 8U, //GPIO8 = D9
    .OUTPUT_7           = 10U,//GPI10 = On J3 connector
    .OUTPUT_8           = 11U,//GPI11 = On J3 connector
    //Other IO pins
    .LED_ON_BOARD       = 21U,//GPIO21
    .I2C_SDA            = 5U, //GPIO5 = D4
    .I2C_SCL            = 6U, //GPIO6 = D5
    .SERIAL_PORT_1_RX   = 44U,//GPIO44 = D7
    .SERIAL_PORT_1_TX   = 45U,//GPIO45 = Unmapped pin on the XIAO. Remap if you want to use CRSF telemetry i.e. Try D6 if no external LED used.
    .SERIAL_PORT_2_RX   = 12U,//GPIO11 = On J3 connector
    .SERIAL_PORT_2_TX   = 13U,//GPIO12 = On J3 connector
    .LED_EXTERNAL       = 43U,//GPIO1 = D6
    .BATTERY_ADC        = 9U, //GPIO9 = D10
    //Options
    .SINK_ONBOARD_LED         = true,   //Set true to sink onboard LED, false to source onboard LED. 
    .HAS_NEOPIXEL             = false,  //When using a board with a Neopixel i.e. WS2812 or equivalent.
    .SWAP_NEOPIXEL_RGB_TO_GRB = false,  //If your neopixel ordering is green-red-blue then set this to true.
  };


  /**
  * @brief Structure representing the standard IO map for ESP32S3-ZERO by Waveshare.
  */
  static constexpr Board ZERO = 
  {
    //LEDC channel pins used for servos/motors.
    .OUTPUT_1           = 1U,   //GPIO1 
    .OUTPUT_2           = 2U,   //GPIO2
    .OUTPUT_3           = 3U,   //GPIO3
    .OUTPUT_4           = 4U,   //GPIO4
    .OUTPUT_5           = 5U,   //GPIO5
    .OUTPUT_6           = 6U,   //GPIO6
    .OUTPUT_7           = 7U,   //GPIO7
    .OUTPUT_8           = 8U,   //GPIO8
    //Other IO pins
    .LED_ON_BOARD       = 21U,  //GPIO21
    .I2C_SDA            = 9U,   //GPIO9
    .I2C_SCL            = 10U,  //GPIO10
    .SERIAL_PORT_1_RX   = 44U,  //GPIO44
    .SERIAL_PORT_1_TX   = 43U,  //GPIO43
    .SERIAL_PORT_2_RX   = 11U,  //GPIO11
    .SERIAL_PORT_2_TX   = 12U,  //GPIO12
    .LED_EXTERNAL       = 14U,  //GPIO14
    .BATTERY_ADC        = 13U,  //GPIO13
    //GPIO 14, 15, 16, 17, 18, 38, 39, 40, 41, 42, 45 spare
    //Options
    .SINK_ONBOARD_LED         = false,  //Set true to sink onboard LED, false to source onboard LED. 
    .HAS_NEOPIXEL             = true,   //When using a board with a Neopixel i.e. WS2812 or equivalent.
    .SWAP_NEOPIXEL_RGB_TO_GRB = true,   //If your neopixel ordering is green-red-blue then set this to true.
  };


  /**
  * @brief Structure representing the standard IO map for ESP32S3-TINY by Waveshare.
  */
  static constexpr Board TINY = 
  {
    //LEDC channel pins used for servos/motors.
    .OUTPUT_1           = 1U,   //GPIO1 
    .OUTPUT_2           = 2U,   //GPIO2
    .OUTPUT_3           = 3U,   //GPIO3
    .OUTPUT_4           = 4U,   //GPIO4
    .OUTPUT_5           = 5U,   //GPIO5
    .OUTPUT_6           = 6U,   //GPIO6
    .OUTPUT_7           = 7U,   //GPIO7
    .OUTPUT_8           = 8U,   //GPIO8
    //Other IO pins
    .LED_ON_BOARD       = 38U,  //GPIO38
    .I2C_SDA            = 18U,  //GPIO18
    .I2C_SCL            = 17U,  //GPIO17
    .SERIAL_PORT_1_RX   = 44U,  //GPIO44
    .SERIAL_PORT_1_TX   = 43U,  //GPIO43
    .SERIAL_PORT_2_RX   = 11U,  //GPIO11
    .SERIAL_PORT_2_TX   = 12U,  //GPIO12
    .LED_EXTERNAL       = 14U,  //GPIO14
    .BATTERY_ADC        = 13U,  //GPIO13
    //GPIO 9, 10, 15, 16, 21, 33, 34, 35, 36, 37, 38, 39, 40, 41, 42, 45, 47, 48 spare
    //Options
    .SINK_ONBOARD_LED         = false,  //Set true to sink onboard LED, false to source onboard LED. 
    .HAS_NEOPIXEL             = true,   //When using a board with a Neopixel i.e. WS2812 or equivalent.
    .SWAP_NEOPIXEL_RGB_TO_GRB = true,   //If your neopixel ordering is green-red-blue then set this to true.
  };

/**
* @brief Structure representing the standard IO map for the Waveshare module carrier board by Cyberslug.
*        Rev 0.0 is currently under test
*/
static constexpr Board WSMC = 
{
  //LEDC channel pins used for servos/motors.
  .OUTPUT_1           = 1U,   //GPIO1 
  .OUTPUT_2           = 2U,   //GPIO2
  .OUTPUT_3           = 3U,   //GPIO3
  .OUTPUT_4           = 4U,   //GPIO4
  .OUTPUT_5           = 5U,   //GPIO5
  .OUTPUT_6           = 6U,   //GPIO6
  .OUTPUT_7           = 7U,   //GPIO07
  .OUTPUT_8           = 8U,   //GPIO08
  //Other IO pins
  .LED_ON_BOARD       = 21U,  //GPIO21
  .I2C_SDA            = 9U,   //GPIO09
  .I2C_SCL            = 10U,  //GPIO10
  .SERIAL_PORT_1_RX   = 44U,  //GPIO44
  .SERIAL_PORT_1_TX   = 43U,  //GPIO43
  .SERIAL_PORT_2_RX   = 11U,  //GPIO11
  .SERIAL_PORT_2_TX   = 12U,  //GPIO12
  .LED_EXTERNAL       = 16U,  //GPIO16  not used
  .BATTERY_ADC        = 13U,  //GPIO13
  //GPIO 15, 17, 18, 38, 39, 40, 41, 42, 45 spare
  //Options
  .SINK_ONBOARD_LED         = false,  //Set true to sink onboard LED, false to source onboard LED. 
  .HAS_NEOPIXEL             = true,   //When using a board with a Neopixel i.e. WS2812 or equivalent.
  .SWAP_NEOPIXEL_RGB_TO_GRB = true,  //If your neopixel ordering is green-red-blue then set this to true.
};

}//Namespace BoardConfig end.
