plainFlight/plainFlightController/PlainFlightController/FileSystem.cpp

/* 
* Copyright (c) 2025 P.Cook (alias 'plainFlight')
*
* This file is part of the PlainFlightController distribution (https://github.com/plainFlight/plainFlightController).
* 
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
* You should have received a copy of the GNU General Public License 
* along with this program. If not, see <http://www.gnu.org/licenses/>.
*/

/**
* @file   FileSystem.cpp
* @brief  This class contains methods that controls the reading and writting of flash memory.
*/

#include "FileSystem.hpp"
#include "Monitor.hpp"

/**
* @brief  Start the file system.
* @return True when file system successfully started.
*/
bool 
FileSystem::begin()
{
  String filePath = FILE_DIRECTORY + "/" + FILE_NAME; 
  stringToCharArray(&filePath, m_filePath);
  stringToCharArray(&FILE_DIRECTORY, m_fileDirectory);

  if (!LittleFS.begin(FORMAT_LITTLEFS_IF_FAILED, m_fileDirectory, 1))  
  {
    return false;
  }

  return true;
}


/**
* @brief  Check for presence of a file.
* @return True when file match found.
*/
bool 
FileSystem::fileExists()
{
  return (LittleFS.exists(m_filePath)) ? true : false;
}


/**
* @brief  Creates a file.
* @return True when file successfully created.
*/
bool 
FileSystem::createFile()
{
  Monitor::event(MonitorSource::CONFIGURATOR, "Formatting.");
  LittleFS.format();
  Monitor::event(MonitorSource::CONFIGURATOR, "Create directory.");
  LittleFS.mkdir(FILE_DIRECTORY);

  if (!LittleFS.exists(FILE_DIRECTORY)) 
  {
      Monitor::event(MonitorSource::CONFIGURATOR, "directory not created");
      return false;
  }

  return true;
}


/**
* @brief  converts a string to array of chars.
* @param  str The string to convert.
* @param  charBuff  The buffer to stare the char array in.
*/
void
FileSystem::stringToCharArray(const String* const str, char* const charBuff)
{
  uint32_t strLength = str->length() + 1U;
  str->toCharArray(charBuff, strLength);
}


/**
* @brief  Reads the contents of a file.
* @return True on successful file read.
* @param  fileData  Pointer to string used to store read file data.
*/
bool 
FileSystem::readDataFromFile(String *const fileData)
{
  File file = LittleFS.open(m_filePath);

  if (!file || file.isDirectory()) 
  {
    Monitor::event(MonitorSource::CONFIGURATOR, "- failed to open file for reading");
    return false;
  }

  Monitor::event(MonitorSource::CONFIGURATOR, "- read from file:");

  while (file.available()) 
  {
    *fileData = file.readString();
  }

  file.close();
  return true;
}


/**
* @brief  Start the configurator process/object.
* @return True when configurator successfully started.
* @param  fileData  Pointer to string that holds data to be written to file.
*/
bool 
FileSystem::writeDataToFile(String const * const fileData)
{
  File file = LittleFS.open(m_filePath, FILE_WRITE);

  if (!file) 
  {
    Monitor::event(MonitorSource::CONFIGURATOR, "Failed to open file for writing");
    return false;
  }
  
  //write data here
  Monitor::event(MonitorSource::CONFIGURATOR, "write to file");
  file.print(*fileData);
  file.close();
  return true;
}
