plainFlight/plainFlightController/PlainFlightController/IBus.cpp

/* 
* Copyright (c) 2026 P.Cook (alias 'plainFlight')
*
* This file is part of the PlainFlightController distribution (https://github.com/plainFlight/plainFlightController).
* 
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
* You should have received a copy of the GNU General Public License 
* along with this program. If not, see <http://www.gnu.org/licenses/>.
*/

/**
* @file   IBus.cpp
* @brief  This class handles communications with an IBus RC receiver.
*/

#include "IBus.hpp"
#include "InternalConfig.hpp"
 

/**
* @brief    IBus constructor.
*/
IBus::IBus()
{
  m_uart = InternalConfig::resolveUart(Config::RECEIVER_SERIAL_PORT);
  m_uart->begin(IBUS_BAUD, SERIAL_8N1,
                InternalConfig::resolveRxPin(Config::RECEIVER_SERIAL_PORT),
                InternalConfig::resolveTxPin(Config::RECEIVER_SERIAL_PORT),
                false);
  m_uart->flush();
}


/**
* @brief    Decodes the IBus serial stream into usable channel and flag data.
* @return   Returns true when new data is available.
*/
bool
IBus::getDemands()
{
  uint32_t rawChannels[NUM_IBUS_CH + CHECKSUM_LEN];
  uint8_t bytes[MAX_BYTES_PER_LOOP];
  bool newFrame = false;

  // A single read: every UART call takes the driver lock, so reading one
  // byte per call costs the lock for every byte.
  const uint32_t byteCount = static_cast<uint32_t>(m_uart->read(bytes, sizeof(bytes)));

  for (uint32_t i = 0U; i < byteCount; i++)
  {
    const uint32_t currentByte = bytes[i];
 
    if (0U == m_count)
    {
      if ((COMMAND == currentByte) && (HEADER == m_prevByte))
      {
        m_buff[m_count] = HEADER;
        m_count++;
        m_buff[m_count] = COMMAND;
        m_count++;
      }
    }
    else if (m_count < FRAME_LEN)
    {
      m_buff[m_count] = currentByte;
      m_count++;
 
      if (FRAME_LEN == m_count)
      {
        m_count = 0U;
        const uint16_t rxChecksum =  static_cast<uint32_t>(m_buff[30] | (m_buff[31] << 8U));
        uint16_t calcChecksum = CHECKSUM_START;
 
        for (uint16_t i=0U; i<CHECKSUM_BYTE_LEN; i++)
        {
          calcChecksum -= m_buff[i];
        }

        if (rxChecksum == calcChecksum)
        {
          //Checksum ok so decode the payload
          //Reset communications timer
          lossOfCommsTimer.set(COMMS_TIME_OUT_PERIOD);
          m_rxData.lostComms = false;

          //There is no failsafe bit so set false
          m_rxData.failsafe = false;

          //Decode data
          rawChannels[0] =  static_cast<uint32_t>((m_buff[2]  | (m_buff[3] << 8U))  & 0x07FFU);
          rawChannels[1] =  static_cast<uint32_t>((m_buff[4]  | (m_buff[5] << 8U))  & 0x07FFU);
          rawChannels[2] =  static_cast<uint32_t>((m_buff[6]  | (m_buff[7] << 8U))  & 0x07FFU);
          rawChannels[3] =  static_cast<uint32_t>((m_buff[8]  | (m_buff[9] << 8U))  & 0x07FFU);
          rawChannels[4] =  static_cast<uint32_t>((m_buff[10] | (m_buff[11] << 8U)) & 0x07FFU);
          rawChannels[5] =  static_cast<uint32_t>((m_buff[12] | (m_buff[13] << 8U)) & 0x07FFU);
          rawChannels[6] =  static_cast<uint32_t>((m_buff[14] | (m_buff[15] << 8U)) & 0x07FFU);
          rawChannels[7] =  static_cast<uint32_t>((m_buff[16] | (m_buff[17] << 8U)) & 0x07FFU);
          rawChannels[8] =  static_cast<uint32_t>((m_buff[18] | (m_buff[19] << 8U)) & 0x07FFU);
          rawChannels[9] =  static_cast<uint32_t>((m_buff[20] | (m_buff[21] << 8U)) & 0x07FFU);
          rawChannels[10] = static_cast<uint32_t>((m_buff[22] | (m_buff[23] << 8U)) & 0x07FFU);
          rawChannels[11] = static_cast<uint32_t>((m_buff[24] | (m_buff[25] << 8U)) & 0x07FFU);
          rawChannels[12] = static_cast<uint32_t>((m_buff[26] | (m_buff[27] << 8U)) & 0x07FFU);
          rawChannels[13] = static_cast<uint32_t>((m_buff[28] | (m_buff[29] << 8U)) & 0x07FFU);

          for (uint32_t i = 0U; i < NUM_IBUS_CH; i++)
          {
            const int32_t channel = constrain(rawChannels[i], MIN_IBUS_US, MAX_IBUS_US);
            m_rxData.ch[i] = map32(channel, MIN_IBUS_US, MAX_IBUS_US, MIN_NORMALISED, MAX_NORMALISED);
          }

          newFrame = true;
        }
      }
    }
    else
    {
      m_count = 0U;
    }
 
    m_prevByte = currentByte;
  }
 
  if (CTimer::State::EXPIRED == lossOfCommsTimer.getState())
  {
    m_rxData.lostComms = true;
    m_rxData.failsafe = true;   //Force failsafe
  }
 
  return newFrame;
}
 
/**
* @brief    Returns the most recent receiver data.
* @return   RxPacket containing failsafe, communication status, and normalised channel data.
*/
const RxBase::RxPacket
IBus::getData()
{
  return m_rxData;
}
 
/**
* @brief    Check if communications have been lost.
* @return   true when IBus comms has been lost, false otherwise.
*/
const bool
IBus::hasLostCommunications() const
{
  return m_rxData.lostComms;
}
