plainFlight/plainFlightController/PlainFlightController/ReceiverBearer.hpp

/* 
* Original File Author: D. Gamble (Github: Cyberslug)
*
* Copyright (c) 2026 P.Cook (alias 'plainFlight')
*
* This file is part of the PlainFlightController distribution (https://github.com/plainFlight/plainFlightController).
* 
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
* You should have received a copy of the GNU General Public License 
* along with this program. If not, see <http://www.gnu.org/licenses/>.
*/

/**
* @file   ReceiverBearer.hpp
* @brief  This file contains enums and structures that are used to select and 
*         instantiate the Receiver and Telemetry bearers 
*/

#pragma once

#include "RxBase.hpp"
#include "ITelemetry.hpp"
#include "Config.hpp"
#include "InternalConfig.hpp"
#include "Crsf.hpp"
#include "SBus.hpp"
#include "IBus.hpp"
#include "Srxl2.hpp"


/**
* @class  ReceiverBearer
* @brief  Selects and instantiates the receiver and telemetry bearers based
*         on Config::RECEIVER_TYPE / Config::TELEMETRY_TYPE.
* @note   Adding a new bearer requires a change here only - no other file
*         needs to know which receiver types exist.
*/
class ReceiverBearer
{
  public:
    // Adding a new receiver bearer requires: adding it to
    // ReceiverType and/or TelemetryType in CommonTypes.hpp, then a branch here.
    static void create(RxBase** outReceiver, ITelemetry** outTelemetry)
    {
      static_assert((Config::RECEIVER_TYPE == ReceiverType::SBUS) || (Config::RECEIVER_TYPE == ReceiverType::CRSF) || (Config::RECEIVER_TYPE == ReceiverType::IBUS) || (Config::RECEIVER_TYPE == ReceiverType::SRXL2),
      "Configuration Error: Select RECEIVER_TYPE = SBUS, CRSF, IBUS or SRXL2.");
      
      if constexpr (Config::RECEIVER_TYPE == ReceiverType::CRSF)
      {
        Crsf* crsf = new Crsf();
        *outReceiver = crsf;
        *outTelemetry = (Config::TELEMETRY_TYPE == TelemetryType::NONE) ? nullptr : crsf;
      }
      else if constexpr (Config::RECEIVER_TYPE == ReceiverType::SBUS)
      {
        *outReceiver = new SBus();
        *outTelemetry = nullptr;   // SBus has no telemetry path.
      }
      else if constexpr (Config::RECEIVER_TYPE == ReceiverType::SRXL2)
      {
        *outReceiver = new Srxl2();
        *outTelemetry = nullptr;   // SRXL2 telemetry reply not yet implemented.
      }
      else
      {
        if constexpr (Config::RECEIVER_TYPE == ReceiverType::IBUS)
        {
          *outReceiver = new IBus();
          *outTelemetry = nullptr;   // IBus has no telemetry implemented presently in this code base.
        }

        // Static assert will catch missing Rx type.
      }
    }
};
