plainFlight/plainFlightController/PlainFlightController/ChannelValidation.hpp

/* 
* Original file by D. Gamble (Github: Cyberslug)
*
* Copyright (c) 2026 P.Cook (alias 'plainFlight')
*
* This file is part of the PlainFlightController distribution (https://github.com/plainFlight/plainFlightController).
* 
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
* You should have received a copy of the GNU General Public License 
* along with this program. If not, see <http://www.gnu.org/licenses/>.
*/
/**
* @file   ChannelValidation.hpp
* @brief  Compile-time checks confirming no two RC functions share a channel.
*/
#pragma once

#include "CommonTypes.hpp"
#include "Config.hpp"
#include "RxBase.hpp"

/**
 * @namespace ChannelValidation
 */
namespace ChannelValidation
{
  static constexpr uint32_t toIndex(RcChannelName name)
  {
    return static_cast<uint32_t>(name);
  }

  // Derived directly from Config.hpp, matching the same technique used for
  // InternalConfig::NUMBER_PASS_THROUGH,  kept local to this file so it does
  // not need to include InternalConfig.hpp.
  static constexpr uint32_t PASS_THROUGH_COUNT =
    static_cast<uint32_t>(sizeof(Config::PASS_THROUGH_PINS) / sizeof(Config::PASS_THROUGH_PINS[0]));

  /**
  * @brief  Confirms no two assigned RC functions share the same channel.
  * @return true if any two assigned channels collide, false otherwise.
  */
  static constexpr bool channelIsDuplicated()
  {
    // MAX_RX_CHANNELS is the absolute maximum that can be assigned under any circumstances
    // Practical maximum is actually less than  5 candidates + 8 possible PWM channels
    uint32_t used[RxBase::MAX_RX_CHANNELS] = {};
    uint32_t count = 0U;

    const RcChannelName candidates[] =
    {
      Config::ARM_CHANNEL,
      Config::MODE_CHANNEL,
      Config::FLAPS_CHANNEL,
      Config::HEADING_HOLD_CHANNEL,
      Config::PROP_HANG_CHANNEL,
    };

    // Record those channel functions that are not NONE
    for (const RcChannelName candidate : candidates)
    {
      if (candidate != RcChannelName::NONE)
      {
        used[count++] = toIndex(candidate);
      }
    }

    // Record those pass-through pins that are assigned a channel
    for (uint32_t i = 0U; i < PASS_THROUGH_COUNT; i++)
    {
      used[count++] = toIndex(Config::PASS_THROUGH_PINS[i].channel);
    }

    // Count is the sum of channels assigned
    // Test no element in used[] is equal to any other element
    for (uint32_t i = 0U; i < count; i++)
    {
      for (uint32_t j = (i + 1U); j < count; j++)
      {
        if (used[i] == used[j])
        {
          return true;
        }
      }
    }
    return false;
  }
}
