plainFlight/plainFlightController/PlainFlightController/Utilities.cpp

/* 
* Copyright (c) 2025 P.Cook (alias 'plainFlight')
*
* This file is part of the PlainFlightController distribution (https://github.com/plainFlight/plainFlightController).
* 
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
* You should have received a copy of the GNU General Public License 
* along with this program. If not, see <http://www.gnu.org/licenses/>.
*/

/**
* @file   Utilities.cpp
* @brief  This class contains methods that all clases may call upon
*/

#include "Utilities.hpp"
#include "esp_timer.h"
#include "InternalConfig.hpp"


/**
* @brief    Calculates the loop time just passed and waits (next time in after loop execution) to give a constant loop rate.  
* @note     Using esp_timer_get_time() as it seems to save ~10us over Arduino micros().
*/ 
float
Utilities::loopRateControl()
{
  uint64_t nowTime;
  m_cycleTime = esp_timer_get_time() - m_loopStartTime;

  do{
    nowTime = esp_timer_get_time();
  }while(nowTime < m_loopEndTime);

  m_lastLoopTime = m_loopStartTime;
  m_loopStartTime = nowTime;
  m_loopEndTime = m_loopStartTime + LOOP_RATE_US; 
  m_timeDelta = static_cast<float>((m_loopStartTime - m_lastLoopTime) / 1000000.0f); 
  return m_timeDelta;
}


/**
* @brief    Outputs to console the actual looprate achieved
*/ 
void
Utilities::printLoopRateData()
{
  if constexpr(InternalConfig::DEBUG_LOOP_RATE)
  {
    Serial.print(m_timeDelta, 6);
    Serial.print("\t");
    Serial.print(static_cast<float>(m_cycleTime) / 1000000.0f, 6); 
    Serial.print("\t");
    m_avCycleTime = ((m_avCycleTime * 999.0f) + static_cast<float>(m_cycleTime)) / 1000.0f;
    Serial.println(m_avCycleTime / 1000000.0f, 6);
  }
}

/**
* @brief  A faster implementation of invSqrt.
*/
float 
Utilities::invSqrt(float x) 
{
  unsigned int i = 0x5F1F1412 - (*(unsigned int*)&x >> 1);
  float tmp = *(float*)&i;
  float y = tmp * (1.69000231f - 0.714158168f * x * tmp * tmp);
  return y;
}


/**
* @brief  A faster implementation of atan2 when compared to C library code. Formatting left in original coding style of Author.
* @note   volkansalma/atan2_approximation.c
* @note   https://gist.github.com/volkansalma/2972237
* @note   http://pubs.opengroup.org/onlinepubs/009695399/functions/atan2.html
* @note   Volkan SALMA
*/
float 
Utilities::fastAtan2(float y, float x)
{
  constexpr float ONEQTR_PI = M_PI / 4.0f;
	constexpr float THRQTR_PI = 3.0f * M_PI / 4.0f;
	float r, angle;
	float abs_y = fabs(y) + 1e-10f;      // kludge to prevent 0/0 condition

	if (x < 0.0f)
	{
		r = (x + abs_y) / (abs_y - x);
		angle = THRQTR_PI;
	}
	else
	{
		r = (x - abs_y) / (x + abs_y);
		angle = ONEQTR_PI;
	}

	angle += (0.1963f * r * r - 0.9817f) * r;

	if (y < 0.0f)
	{
      return(-angle);     // negate if in quad III or IV
  }
	else
  {
		return(angle);
  }
}
