plainFlight/plainFlightController/(commit log)

2023-11-20 Initial commit of plainFlightController
    Initial commit of plainFlight stabilisation software for small electric powered model aircraft.
2023-11-23 Moved wiring diagram to assets
2023-11-25 Code tidy
    Code/comment tidy and slight change to motorMixer().
2023-11-25 Structual change
    Reworked Flight_Ctrl mixer functions.
    [Sbus_Rx.h]
2023-11-25 Code tidy
    Removed currentState parameter from modelMixer().
2023-11-26 Switch to using shadow ram for actuators
    Rearranged how actuator values are calculated. Lots of little comment updates.
2023-12-01 Heading hold updates
    Tested/flown - heading hold now allows model to maintain prop hanging and sustains knife-edging :-)
2023-12-05 PIDF defines added
    PIDF defines added, rc debug data updated, option for low battery throttle limiting added, increased i gain wind up to max servo travel.
2023-12-18 Added uncalibrated state
    Following BEC power supply issue on a model added calibrate timeout and uncalibrated state in state machine.
2023-12-19 Bug fix for throttle in failsafe
    referenced servo tick not motor ticks. Also added compile time error if both heading hold modes are enable at same time.
2023-12-21 Restructure Calibrate & defines
    New calibrating state.
    flaps enabled via define not just model mixer.
    Unified rate & levelled corrections reversing defines.
    Increased madgwick accelerometer weighting.
2023-12-28 Instruction Manual Added
    Code updates for differential throttle usage and pass through.
2024-01-15 Variable typo fix Yaw to yaw.
2024-01-29 Create A4 Wing.PNG
2024-01-29 Update A4 Wing.PNG
2024-03-22 v1.1.1 Updates committed
    1, New active throttle reduction upon depleted battery.
    2, New improved self levelled mode that also removes the need for level gains.
    3, New ESC calibration.
    4, LED class, to allow both on board and external LEDs to operate.
    5, Move to map32() to save ~50us per loop iteration.
    6, Minor code improvements e.g. use of const on pointers.
2025-05-04 PlainFlightController 2.0.0 Beta
    Commit of plainFlightController 2.0.0 with addition of multicopters, WiFi configurator, acro trainer mode, and self levelled prop-hang mode.
2025-11-13 Update README with new features and planned changes
    Added details about IMU board orientation and Waveshare board support.
2025-11-13 Update A4 flying wing feature description
    Clarified the description of the A4 flying wing feature and added information about the self level prop-hang feature in version 2.0.0.
2025-11-20 Update README with V2.0.0 features
    Added information about BiCopter and A4 flying wing features in V2.0.0 release.
2025-11-26 Waveshare board support & IMU orientation update
    Support of Waveshare ESP32 -S3 Zero/Tiny with neopixel RGB LEDs.
    Added ability to roll IMU right 90 degrees for alternative mounting.
    Additional comments added.
2025-12-24 Update for V2.1
    Added new manual and IMU rolled 180.
2025-12-24 Enhance README with additional hardware details for V2.1 release
    Updated target board information and added additional MPU6050 breakout board links.
2025-12-24 Update IMU description in README.md
2026-02-02 Fix: Improve motion detection during calibration which would invalidate the calibration.
    [IMU.cpp, IMU.hpp]
2026-02-02 WIP: IMU changes as per the PR
2026-02-08 Minor Updates for...
    Comments, consts and U's added to IMU and SBus files. While MISRA is not run on this project I try to keep the basics of it in place.
2026-02-08 IMU calibration updates
    Removed unused CALIBRATION_TIMEOUT constexpr. Additional comments around variance threshold in IMU.hpp. Increased CALIBRATE_MAX_VARIANCE_THRESHOLD to 100 as real worlds test on a fixed wing model proved difficult to pass calibration.
    IMU.cpp - stopped calibration debug from spamming console every milli second.
    [IMU.cpp, IMU.hpp]
2026-02-08 Removed I2C_CLK_1MHZ
    Removed unused I2C_CLK_1MHZ from IMU.cpp
2026-02-08 Minor fixes
    Fixed case error in SBus.cpp include that causes issues with Platformio on Unix.
    Minor code comment corrections too.
    [IMU.cpp, IMU.hpp, SBus.cpp]
2026-02-19 Update to use ESP_SoftWire for i2c.
    Move away from Arduino Wire library to ESP32_SoftWire. This bit bang library offers a significant time saving of ~250us over the 1000us loop. Shout out to Cyberslug for recommending this.
    Note: this commit does not include an update to the instruction/user manual. This will follow and address the need to install ESP32_SoftWire library.
2026-02-21 Fixed 4 bugs in Modeltypes and a variable naming inconsistency
    [ModelTypes.hpp]
2026-02-21 Fixed 4 compiler warnings, actually implemented channel selection (it was bypassed) and reverted variables to correct type in crsf.
    [Crsf.cpp, Crsf.hpp, DemandProcessor.cpp, LED.hpp, RxBase.hpp, SBus.hpp, WifiConfig.cpp, WifiConfig.hpp]
2026-02-21 fixed additional areas where channel selection was bypassed.
    [DemandProcessor.cpp]
2026-02-28 SBus & minor updates
    Added Hz output to SBus and added MAX_BYTES_PER_LOOP to align with CRSF.
    A few general comments added and formatting corrections along with consts (a MISRA requirement).
    Compiles and ground tested both CRSF and SBus protocols.
    [Config.hpp, Crsf.cpp, RxBase.hpp, SBus.cpp, SBus.hpp]
2026-03-12 BoardConfig upgrade
    Upgrade to use board configs. Configs are contained in structures that represent the boards IO.
2026-03-12 Update BoardConfig.hpp
    Pin corrections to XIAO board !!
    [BoardConfig.hpp]
2026-03-12 Update BoardConfig.hpp
    Comment corrections.
    [BoardConfig.hpp]
2026-03-14 Update BoardConfig.hpp
    Grammar fix.
    [BoardConfig.hpp]
2026-03-27 Neopixel update to BoardConfig.hpp
    Moved onboard Neopixel setting from Config.hpp to BoardConfig.hpp as they are board specific.
2026-03-27 Update ModelTypes.hpp
    Fixed a few comments.
    [ModelTypes.hpp]
2026-04-18 Update IMU.cpp
    Made console message more sensible for when an unrecognised I2C device is found.
2026-04-27 Servo travel extents
    Added EXTEND_SERVO_TRAVEL_RANGE to Config.hpp to allow servo travel range from 0.8ms to 2.2ms. This is useful when you use saved trims to centre a servo horn due to spline miss alignment.
2026-05-03 Reworked Html.hpp
    Added validation and improved the UX
    [Html.hpp]
2026-05-03 Included HTTP headers in response
    Missing HTTP headers prevented Safari to properly receive and parse the response.
    [WifiConfig.cpp]
2026-05-07 Added http headers and redesigned the web UI
    Added http headers to the response to enable iOS/Safari to parse the response. Added validation to the web forms and improved the overall usability of the web UI.
    [Html.hpp, WifiConfig.cpp]
2026-05-07 Removed pio & vscode files
    Removed pio and vscode folders/files from PR/26.
    Though it does raise the question if these should be included in the future, but removing now to keep the project 'Arduino' for simplicity.
2026-05-07 Fixed misalignment of the second and consequent forms
    Removed a stray DIV element from the first form.
    [Html.hpp]
2026-05-08 Minor fix to HTML
    Minor fix to HTML.hpp to resolve an alignment issue.
    [Html.hpp]
2026-05-16 Address PR#27 review: style/formatting + one bug
    [ModelTypes.hpp]
2026-05-16 Address further PR review comments: reversed incorrect unsigned constant changes
    [ModelTypes.hpp]
2026-05-17 Change output reverse definition and add supporting structure
    [Config.hpp, ModelTypes.hpp]
2026-05-17 Update ModelTypes.hpp
    Swapped lines 77 & 78 in ModelTypes.hpp to fix initialisation error of both REVERSE_OUTPUTS and EXTEND_SERVO_TRAVEL_RANGE.
    [ModelTypes.hpp]
2026-05-17 Update LedcServo.cpp
    Update to setTimerTicks() to make servo reverse work full range when m_extendTravelLimits is set.
    [LedcServo.cpp]
2026-05-18 Bug fix: revised multicopterMotorMagic function was still using old MinThrottleTicks reference.
    [ModelTypes.hpp]
2026-05-20 fixed untyped literals and formatting
    [ModelTypes.hpp]
2026-05-23 restructure output pin allocation
2026-05-24 Documented ModelTypes and added some missed config changes
    [FileSystem.cpp, IMU.cpp, ModelTypes.hpp]
2026-05-24 added assertion safety net for servo/motor config
2026-05-25 change gyro rate range config to enum
2026-05-29 LED.hpp update
    Issue fix with XIAO LED being inverted. Took opportunity to add LED sink/source option back in as part of the fix now we have BoardConfig.hpp
    Also fixed board pin issue for unused Tx pin on XIAO and assigned it to an unrouted pin to allow use of external LED.
    [BoardConfig.hpp, FlightControl.hpp, LED.hpp]
2026-06-12 An alternate solution to issue #35
    [ModelTypes.hpp]
2026-06-19 Debug update
    Update to some debug code so it is only compiled in when used. This brough printData() methods in line and saved a grand total of 100 bytes of code space.
2026-06-20 Initial entry - working battery telemetry
2026-06-20 Changed battery telemetry parameter to be by reference
2026-06-26 First commit of pass through
    Still a few small issues to resolve and general tidy up required.
    [BoardConfig.hpp, Config.hpp, DemandProcessor.hpp, FlightControl.cpp, InternalConfig.hpp, ModelTypes.hpp, RxBase.hpp]
2026-06-27 std::span applied.
    Fix to writeToOutputs() to allow handlePassThroughChannel() to pass an array.
    [ModelTypes.hpp]
2026-06-28 Further style fixes before PR
    [CommonTypes.hpp, Config.hpp, DemandProcessor.hpp, ModelTypes.hpp]
2026-07-03 Claim brag rights and add module board definition
2026-07-03 As requested - remove bug fix and separate GPS config
    [Config.hpp, FlightControl.cpp]
2026-07-03 Fixed ground speed error (another TBS bug) and updated config comment
    [Config.hpp, CrsfCodec.cpp]
2026-07-03 Config comment corrections
    Line 31 was missing section 7 GPS.
    [Config.hpp]
2026-07-05 GPS & OI Update
    Default GPS to NONE. Add GPS IO pins to ZERO and TINY boards.
2026-07-05 Fixed SBus 18 channel processing, add guard to FLAPS in DemandProcessor
    [DemandProcessor.cpp, RxBase.hpp, SBus.cpp, SBus.hpp]
2026-07-14 Remove redundant gyro reversals
    [Config.hpp, FlightControl.cpp, IMU.cpp]
2026-07-20 Board & Manual corrections
    Zero board had pin 12 clash. Instruction manual updated to show correct ESP32_SoftWire library.
    [BoardConfig.hpp]
2026-07-21 Created place holder for WSMC PCB.
    PCBs folder added for upcoming PCBs.
2026-07-22 WSMC PCB added
    Added WSMC PCB by Cyberslug.
2026-07-22 PCB Specs updates
    WSMC & WSMC Mini specifications updated. WSMC image cropped.
2026-07-26 Update to XIAO BoardConfig
    Added outputs 7 & 8 along with GPS pins. However, these are mapped to J3 connector.
2026-07-27 Update PlainFlightController V2.x.x.pdf
    Instruction manual update to remove IMU reversing as this function is now done by servo reversing.
2026-07-31 IBus Rx Protocol Added
    IBus has been bench tested but not flown. Tested with TGY-i6 transmitter.
2026-08-10 Update IBus.cpp
    Ibus to IBus correct for include file.
    [IBus.cpp]
2026-08-10 IBus.cpp code style fixes
    [IBus.cpp]
2026-09-06 PIDDF commit
    Split of D gain in to D smoothing filter for gyro input and DFF for stick response/acceleration.
    HTML/GUI updated to reflect this change with new D gain fields for the stick acceleration.
2026-09-20 Stick response feature
    Added stick response class to DemandProcessor to accelerate control surfaces to stick changes.
    Fixed quadcopter mixer following board orientation updates.
    [Configurator.hpp, DemandProcessor.cpp, DemandProcessor.hpp, FlightControl.cpp, Html.hpp, ModelTypes.hpp, PIDF.cpp, WifiConfig.cpp]
2026-09-27 Corrections
    Conditional compiles added to DemandProcessor for heading hold & prop hang modes.
    Added bounds checking to getChannelIndex()
    [Crsf.hpp, DemandProcessor.cpp, IBus.hpp, SBus.hpp]
2026-10-18 Add read-only accessors for controller state
    Getters that let debugging or logging code observe the controller
    without changing it. None are called by the firmware itself, so they
    add no code unless used.
    - Utilities: cycle time, loop start time and loop period
    - PIDF: last setpoint, measurement, P/I/D/F terms and output
    - ModelBase: last commanded output ticks, outputs and output counts
    - RxBase: getLinkQuality() (default: not available), with CRSF and
    SRXL2 versions
    - DemandProcessor: newRxPacket() and getReceiver()
    - FlightControl: getters for flight state, IMU, demands, PIDFs, model,
    battery monitor and configuration, plus the last GNSS sample and an
    update count
2026-10-18 Limit CRSF and SBUS raw channel values before normalising
    The raw channel values are unsigned. A value below the bottom of the
    range (172) made (x - in_min) in map32() wrap, so the normalised value
    became about +2,619,000 instead of about -1024: a channel driven below
    -100% read as a switch in its high position or a stick at full
    deflection the other way. Constrain the raw value first, as IBus and
    SRXL2 already do.
2026-11-02 Add debug for Battery
2026-11-02 Add debug for IMU (also improved MAdgwick output)
2026-11-02 Add work arounds for Calibration and Config
2026-11-02 Name SerialMonitor constants, fix printRx comment
2026-11-03 Crsf: read the UART in one call per loop
    Replace the per-byte available()/read() loop with a single
    read(buffer, size) and parse the buffer. A good RC frame sets a flag
    instead of returning early, so bytes after it are not discarded.
    MAX_BYTES_PER_LOOP raised from 10 to 64.
2026-11-03 Srxl2: read the UART in one call per loop
    read(buffer, size) and parse the buffer. A good frame sets a flag
    MAX_BYTES_PER_LOOP raised from 12 to 64.
    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
2026-11-03 SBus: read the UART in one call per loop
    MAX_BYTES_PER_LOOP raised from 6 to 64.
    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
2026-11-03 IBus: read the UART in one call per loop
    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
2026-11-04 Replace gyro calibration debug
2026-11-08 Changed the location of lsm6dsox board address to the driver
2026-11-08 Adapt LSM6DSOX driver to Monitor
2026-11-08 Remove SPI transport from LSM6DSOX driver
    The SPI path was never selectable on any board (every board declared
    I2C) and its pin allocation is unresolved, so take it out of this PR and
    leave it for a later change. Both IMU drivers keep the shared SoftI2CBus.
    - Delete SpiBus.hpp/.cpp
    - Drop ImuBus, IMU_BUS and IMU_SPI_CS from BoardConfig.hpp (file restored
    to its main version)
    - Lsm6dsox: DeviceBus is SoftI2CBus; begin() calls the I2C begin directly
    - Mpu6050: remove the SPI board guard, no longer needed
2026-11-08 Tidy comments left from the SPI transport
2026-11-08 Mpu650: check GYRO_RATE only when it is the selected IMU
2026-11-08 LSM6DSOX: run at 1667 Hz, gyro LPF1 25.1 Hz
2026-11-09 Move IMU selection to correct section in Config.hpp
